OpenSourceSDRLab/USRP-B210-Artix-7-AD9361/hardware/USRP-B210-Artix-7-AD9361_Schematic.pdf

## © 2026 OpenSourceSDRLab. All rights reserved. · www.opensourcesdrlab.com

# OPENSOURCESDRLAB DOCUMENTATION

# USRP-B210-Artix-7-AD9361 Schematic

Product | USRP-B210-Artix-7-AD9361
Document | OSSDRLAB-USRP-B210-Artix-7-AD9361-SCH
Version | 1.0
Date | 2026-11-12

Circuit schematic of the OpenSourceSDRLab USRP B210 (Artix-7), a USRP B210-compatible SDR with an Analog Devices AD9361 and a Xilinx Artix-7 XC7A75T or XC7A200T FPGA. Exported from Altium Designer (A4); sheet 13 is blank. The short Chinese notes on sheets 6 and 7 mark pins that may be swapped within an FPGA bank; the note on sheet 12 says that there is no onboard GPSDO (external reference inputs only).

Sheet | Content
1–2 | USB 3.0: CYUSB3014 (FX3) controller, GPIF II bus, Type-C connector and FX3 supply
3 | Power: MP2145 step-down converters, TPS7A9101 low-noise LDOs
4–5 | FPGA configuration, power pins and decoupling
6–7 | FPGA I/O banks: AD9361 interface, FX3 GPIF II, PLL control, GPIO
8 | AD9361 RF transceiver
9–10 | RF front ends, channel 1 (TRX1, RX1) and channel 2 (TRX2, RX2)
11 | Status LEDs, MX1.25 GPIO connector, FPGA and FX3 JTAG
12 | Clocking: ADF4001 PLL, external 10 MHz and PPS inputs (no onboard GPSDO)

Product page: https://opensourcesdrlab.com/products/opensourcesdrlab-usrp-b210-ad9361-and-xilinx-xc7a75t-or-xc7a200t (https://opensourcesdrlab.com/products/opensourcesdrlab-usrp-b210-ad9361-and-xilinx-xc7a75t-or-xc7a200t)

# Questions about the hardware: support@opensourcesdrlab.com

] F7 | GPIO[5] F8 | GPIO[1] F9 | GPIO[0] F10 | GPIO[42]/A

C110

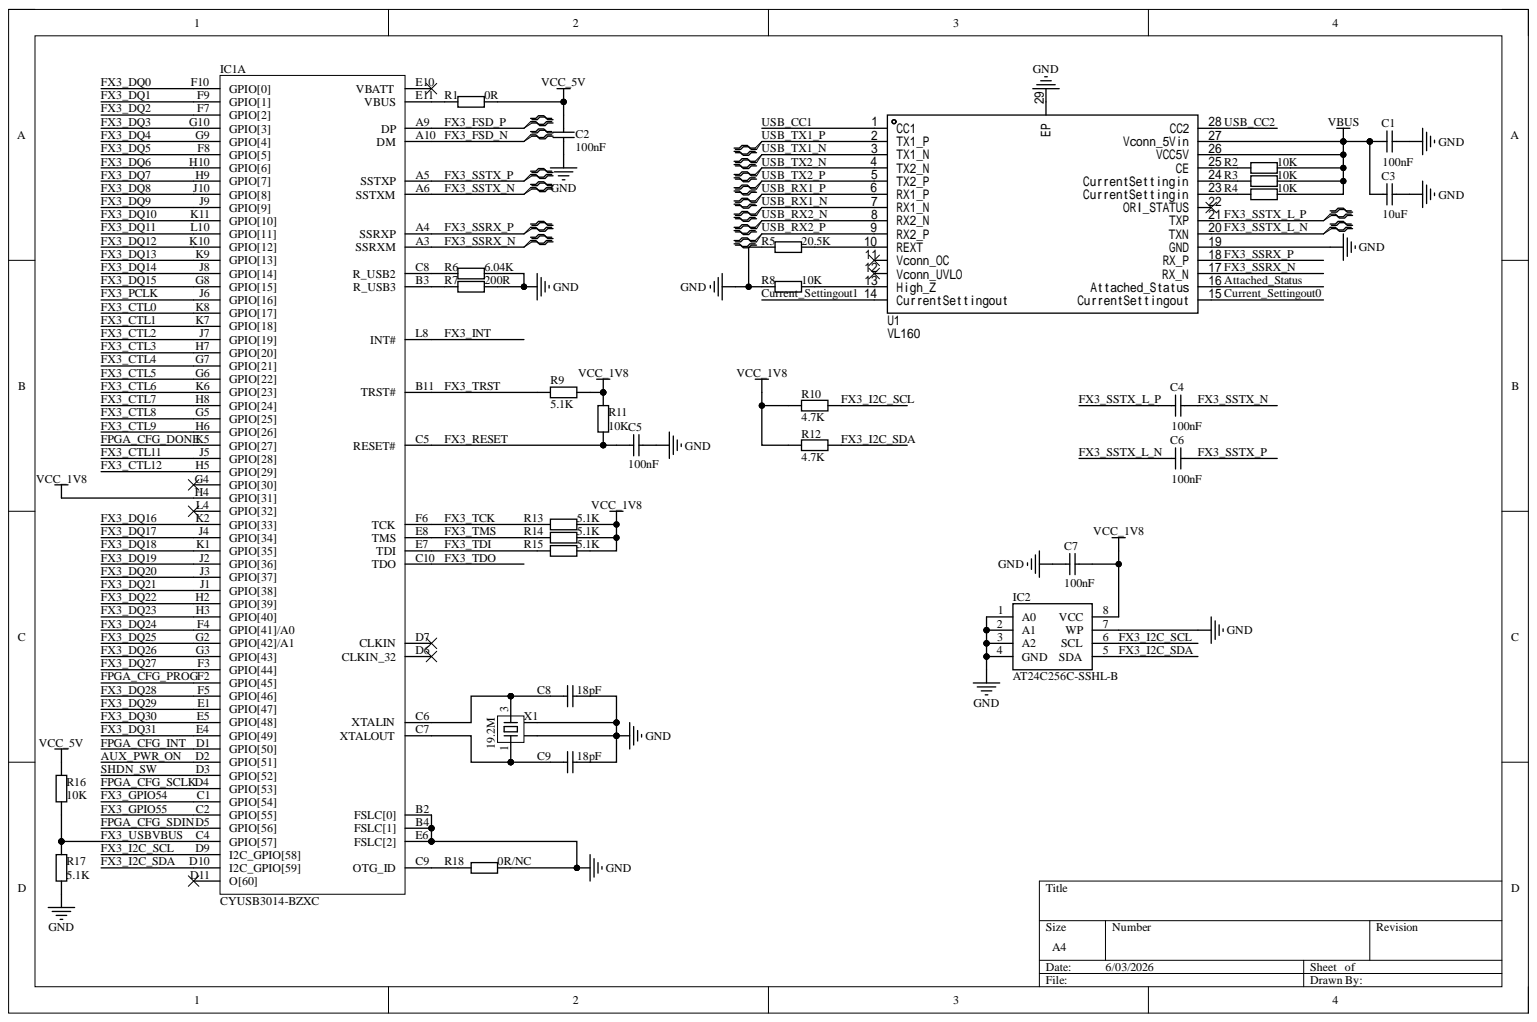
[picture p7: page 2]

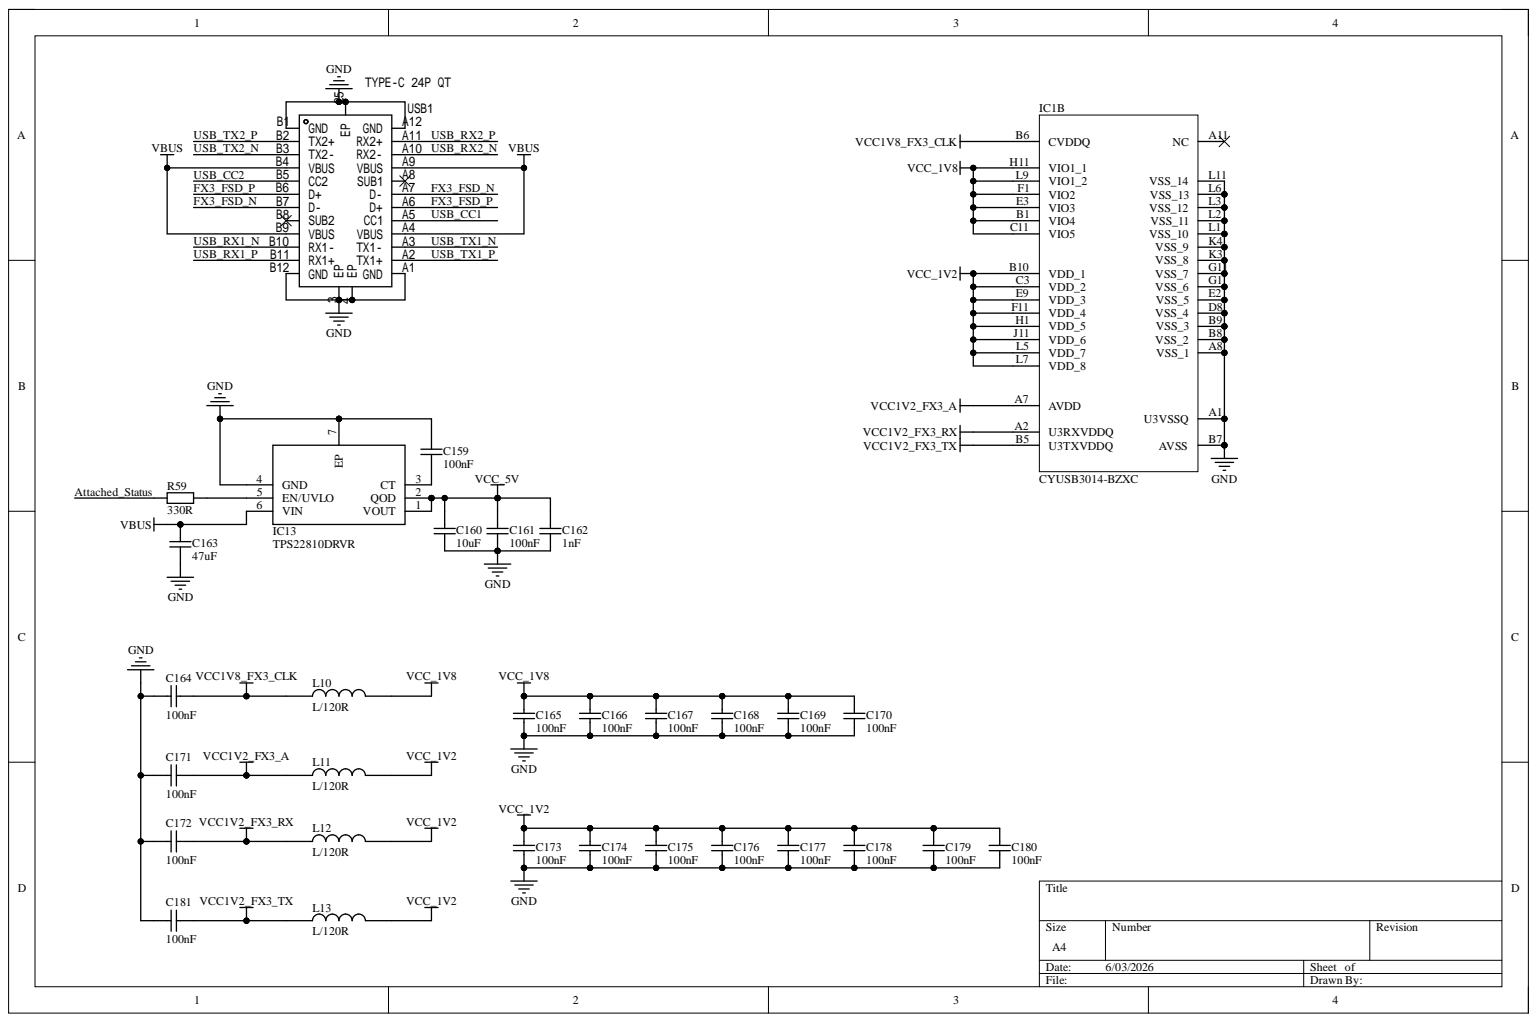
[picture p8: page 3]

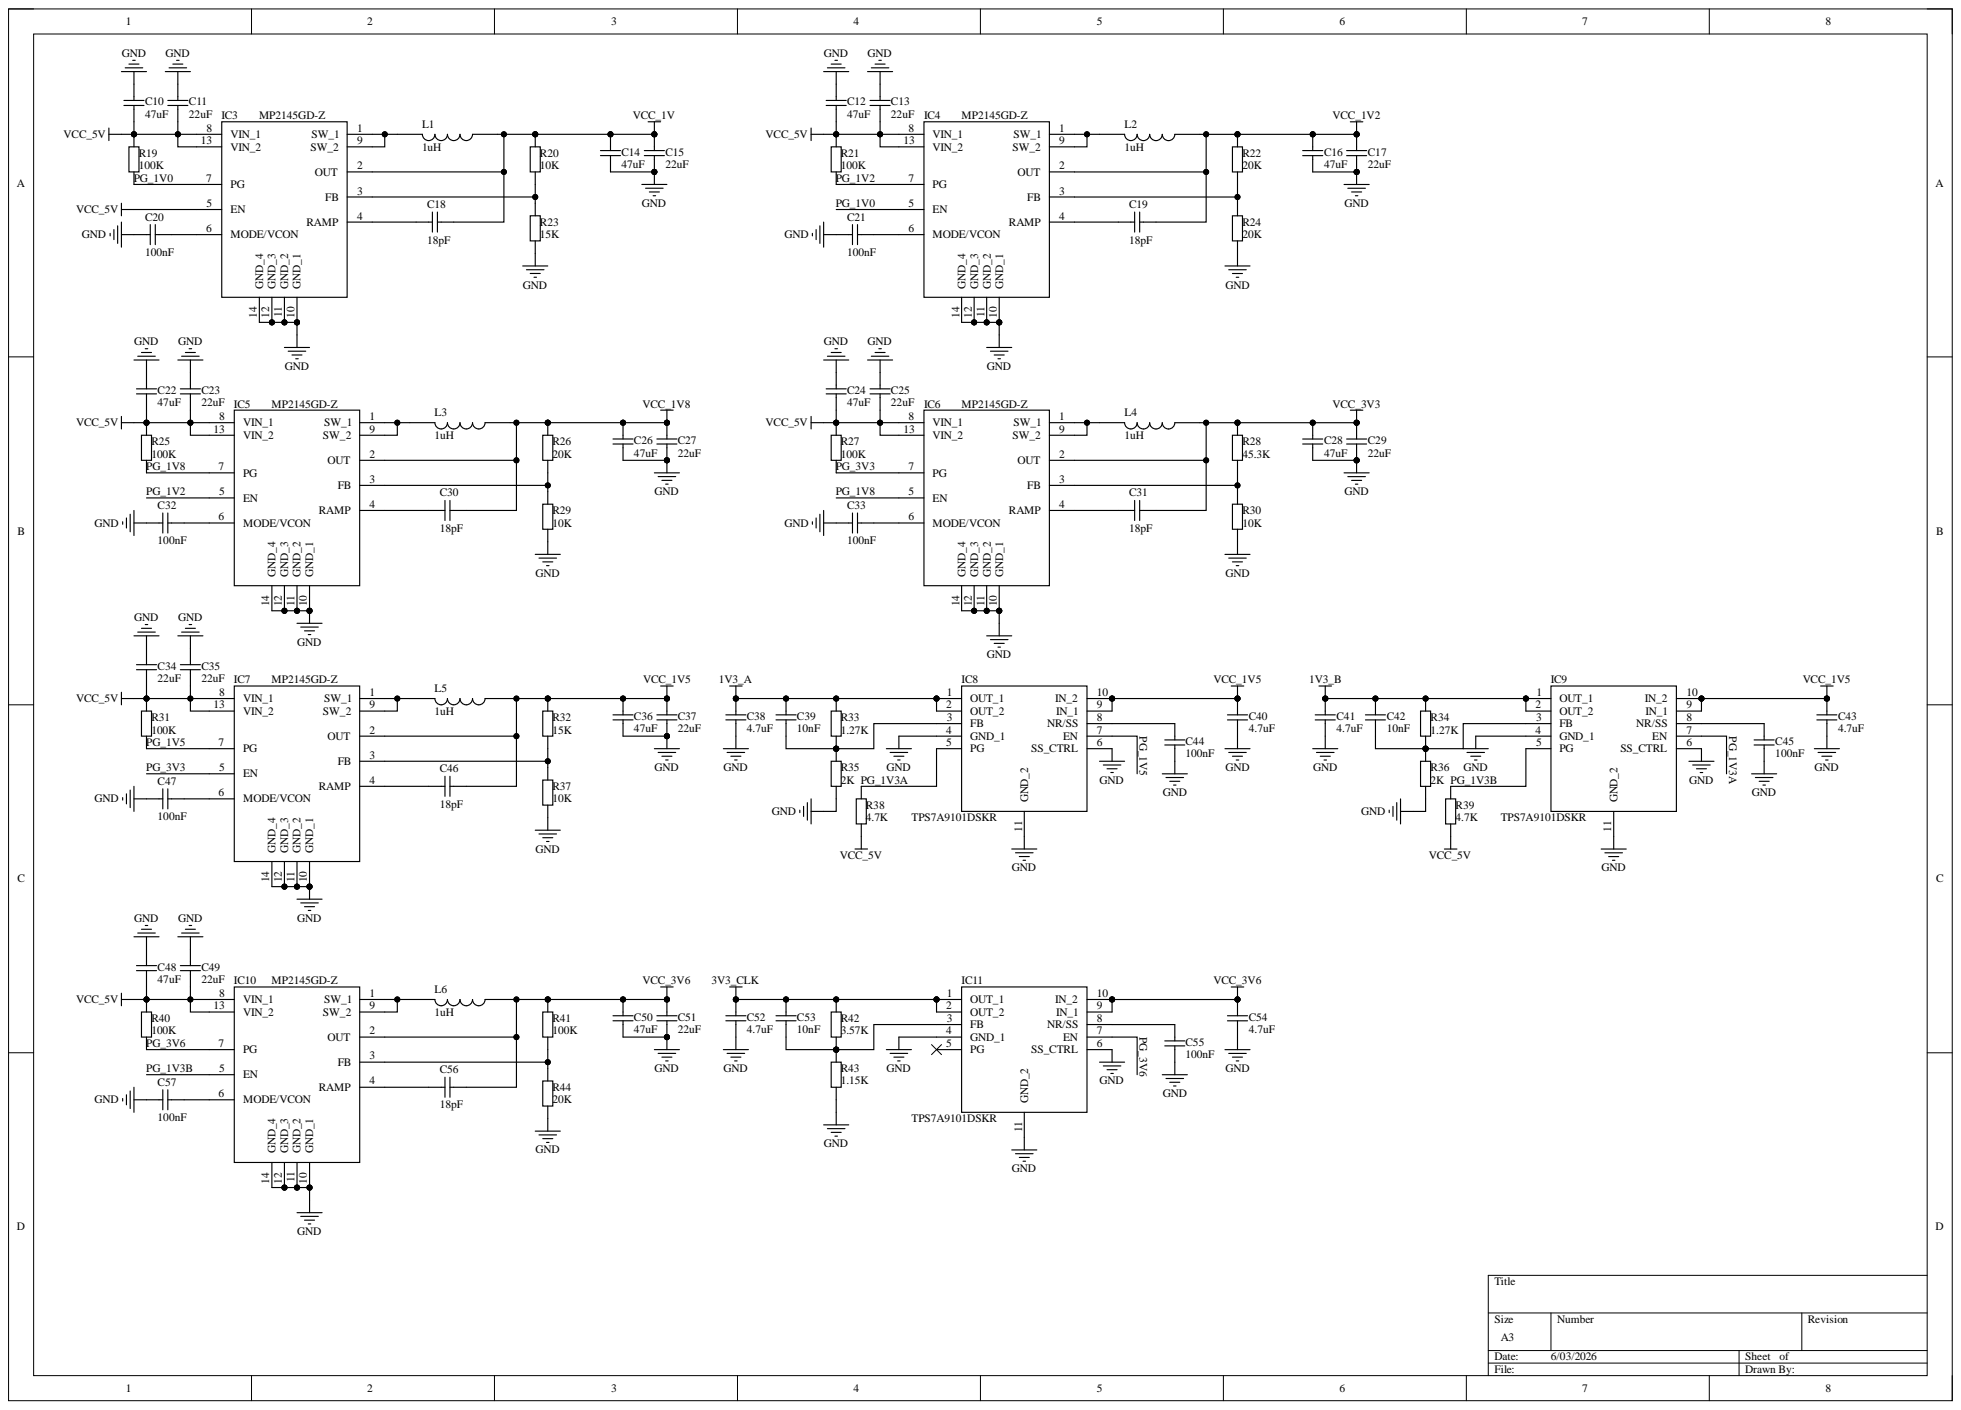
[picture p9: page 4]

0 M10 | VN_0 M9 | TCK_0 V12 | DONE_0 G11 U2G XC7A75T-1FG

### COU2G

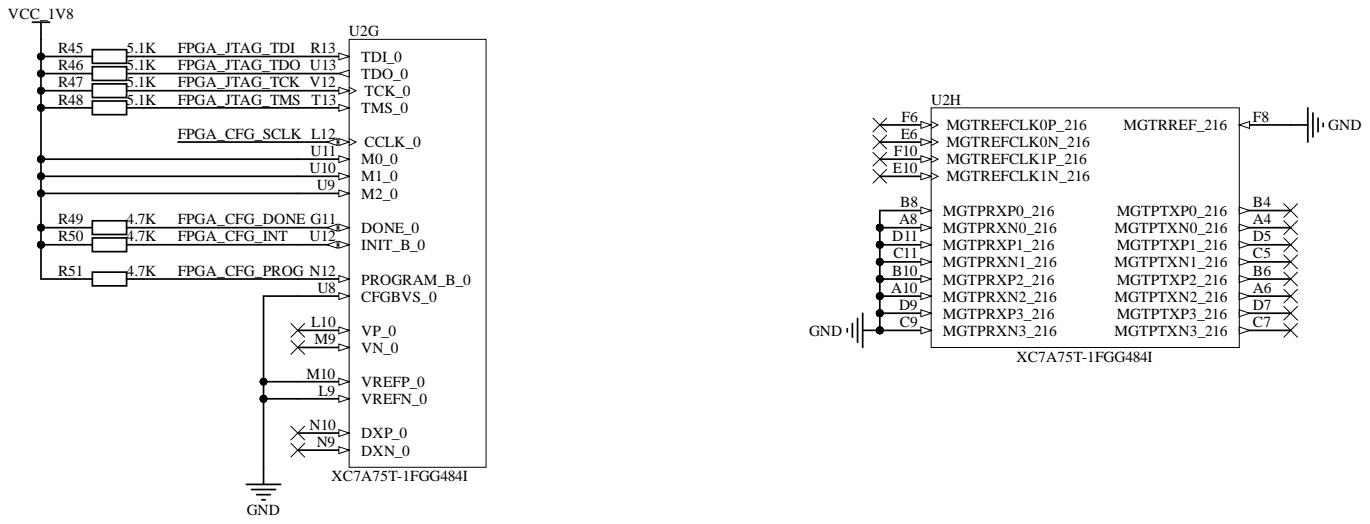
[picture p10: page 5]

GND | Y15 GND | Y5 GND | W18 GND | W8 GND | V21 GND | V11 GND | V1 GND | U14 GND | U4 GND | T17 GND | T11 GND | T9 GND | T7 GND | R20 GND | R12 GND | R10 GND | R8 GND | P13 GND | P11 GND | P9 GND | P7 GND | P3 GND | N16 GND | N8 GND | N6 GND | M19 GND | M11 GND | M7 GND | L22 GND | L8 GND | L2 GND | K15 GND | K11 GND | K7 GND | K5 GND | J18 GND | J12 GND | J10
GND J8 | GND H21 | GND H11 | GND H9 | GND H7 | GND H1 | GND G14 | GND G12 | GND G10 | GND G9 | GND G8 | GND G7 | GND G6 | GND G5 | GND F17 | GND F11 | GND F5 | GND E20 | GND E11 | GND E9 | GND E7 | GND E5 | GND E4 | GND D13 | GND D12

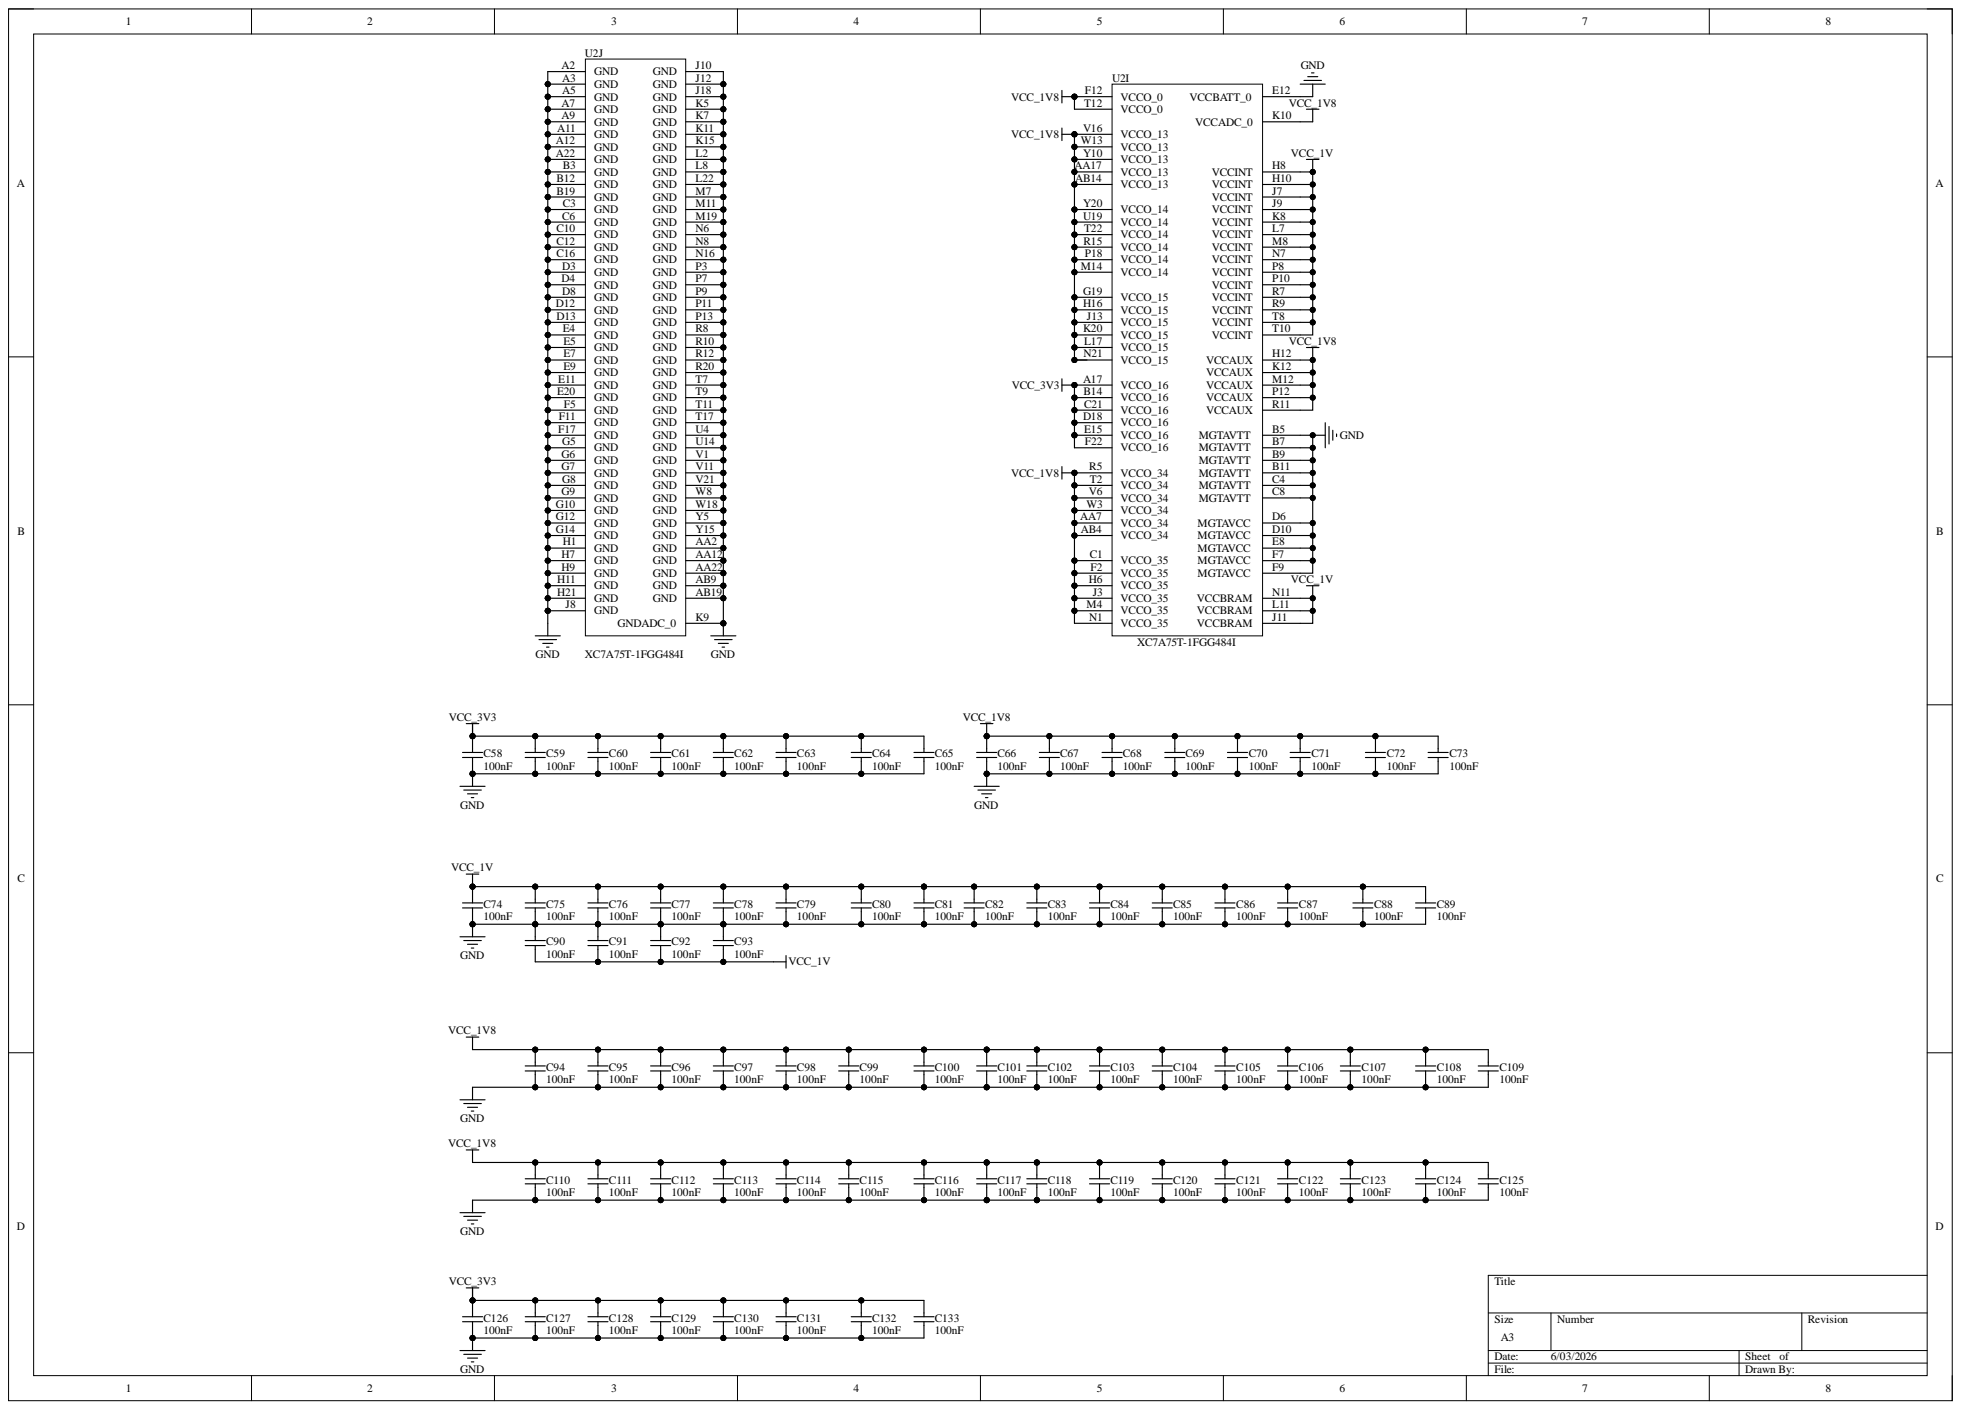
[picture p11: page 6]

8 IO_L17P_T2_A14_D30_14 | AA18 IO_L16N_T2_A15_D31_14 | W17 IO_L16P_T2_CSI_B_14 | V17 IO_L15N_T2_DQS_DOUT_CSO_B_14 | AB20 IO_L15P_T2_DQS_RDWR_B_14 | AA19 IO_L14N_T2_SRCC_14 | V19 IO_L14P_T2_SRCC_14 | V18 IO_L13N_T2_MRCC_14 | Y19 IO_L13P_T2_MRCC_14 | Y18 IO_L12N_T1_MRCC_14 | W20 IO_L12P_T1_MRCC_14 | W19 IO_L11N_T1_SRCC_14 | V20 IO_L11P_T1_SRCC_14 | U20 IO_L10N_T1_D15_14 | AB22 IO_L10P_T1_D14_14 | AB21 IO_L9N_T1_DQS_D13_14 | Y22 IO_L9P_T1_DQS_14 | Y21 IO_L8N_T1_D12_14 | AA21 IO_L8P_T1_D11_14 | AA20 IO_L7N_T1_D10_14 | W22 IO_L7P_T1_D09_14 | W21 IO_L6N_T0_D08_VREF_14 | T20 IO_L6P_T0_FCS_B_14 | T19 IO_L5N_T0_D07_14 | R19 IO_L5P_T0_D06_14 | P19 IO_L4N_T0_D05_14 | U21 IO_L4P_T0_D04_14 | T21 IO_L3N_T0_DQS_EMCCLK_14 | V22 IO_L3P_T0_DQS_PUDC_B_14 | U22 IO_L2N_T0_D03_14 | R21 IO_L2P_T0_D02_14 | P21 IO_L1N_T0_D01_DIN_14 | R22 IO_L1P_T0_D00_MOSI_14 | P22 IO_0_14 | P20 BANK ¹⁴ U2B XC7A75T-1FGG484I
7 IO_L24N_T3_RS0_15 | M16 IO_L24P_T3_RS1_15 | M15 IO_L23N_T3_FWE_B_15 | K16 IO_L23P_T3_FOE_B_15 | L16 IO_L22N_T3_A16_15 | L15 IO_L22P_T3_A17_15 | L14 IO_L21N_T3_DQS_A18_15 | J17 IO_L21P_T3_DQS_15 | K17 IO_L20N_T3_A19_15 | L13 IO_L20P_T3_A20_15 | M13 IO_L19N_T3_A21_VREF_15 | K14 IO_L19P_T3_A22_15 | K13 IO_L18N_T2_A23_15 | M20 IO_L18P_T2_A24_15 | N20 IO_L17N_T2_A25_15 | N19 IO_L17P_T2_A26_15 | N18 IO_L16N_T2_A27_15 | L18 IO_L16P_T2_A28_15 | M18 IO_L15N_T2_DQS_ADV_B_15 | M22 IO_L15P_T2_DQS_15 | N22 IO_L14N_T2_SRCC_15 | L20 IO_L14P_T2_SRCC_15 | L19 IO_L13N_T2_MRCC_15 | K19 IO_L13P_T2_MRCC_15 | K18 IO_L12N_T1_MRCC_15 | H19 IO_L12P_T1_MRCC_15 | J19 IO_L11N_T1_SRCC_15 | J21 IO_L11P_T1_SRCC_15 | J20 IO_L10N_T1_AD11N_15 | L21 IO_L10P_T1_AD11P_15 | M21 IO_L9N_T1_DQS_AD3N_15 | K22 IO_L9P_T1_DQS_AD3P_15 | K21 IO_L8N_T1_AD10N_15 | G20 IO_L8P_T1_AD10P_15 | H20 IO_L7N_T1_AD2N_15 | H22 IO_L7P_T1_AD2P_15 | J22 IO_L6N_T0_VREF_15 | H18 IO_L6P_T0_15 | H17 IO_L5N_T0_AD9N_15 | H15 IO_L5P_T0_AD9P_15 | J15 IO_L4N_T0_15 | G18 IO_L4P_T0_15 | G17 IO_L3N_T0_DQS_AD1N_15 | H14 IO_L3P_T0_DQS_AD1P_15 | J14 IO_L2N_T0_AD8N_15 | G16 IO_L2P_T0_AD8P_15 | G15 IO_L1N_T0_AD0N_15 | G13 IO_L1P_T0_AD0P_15 | H13 IO_0_15 | J16

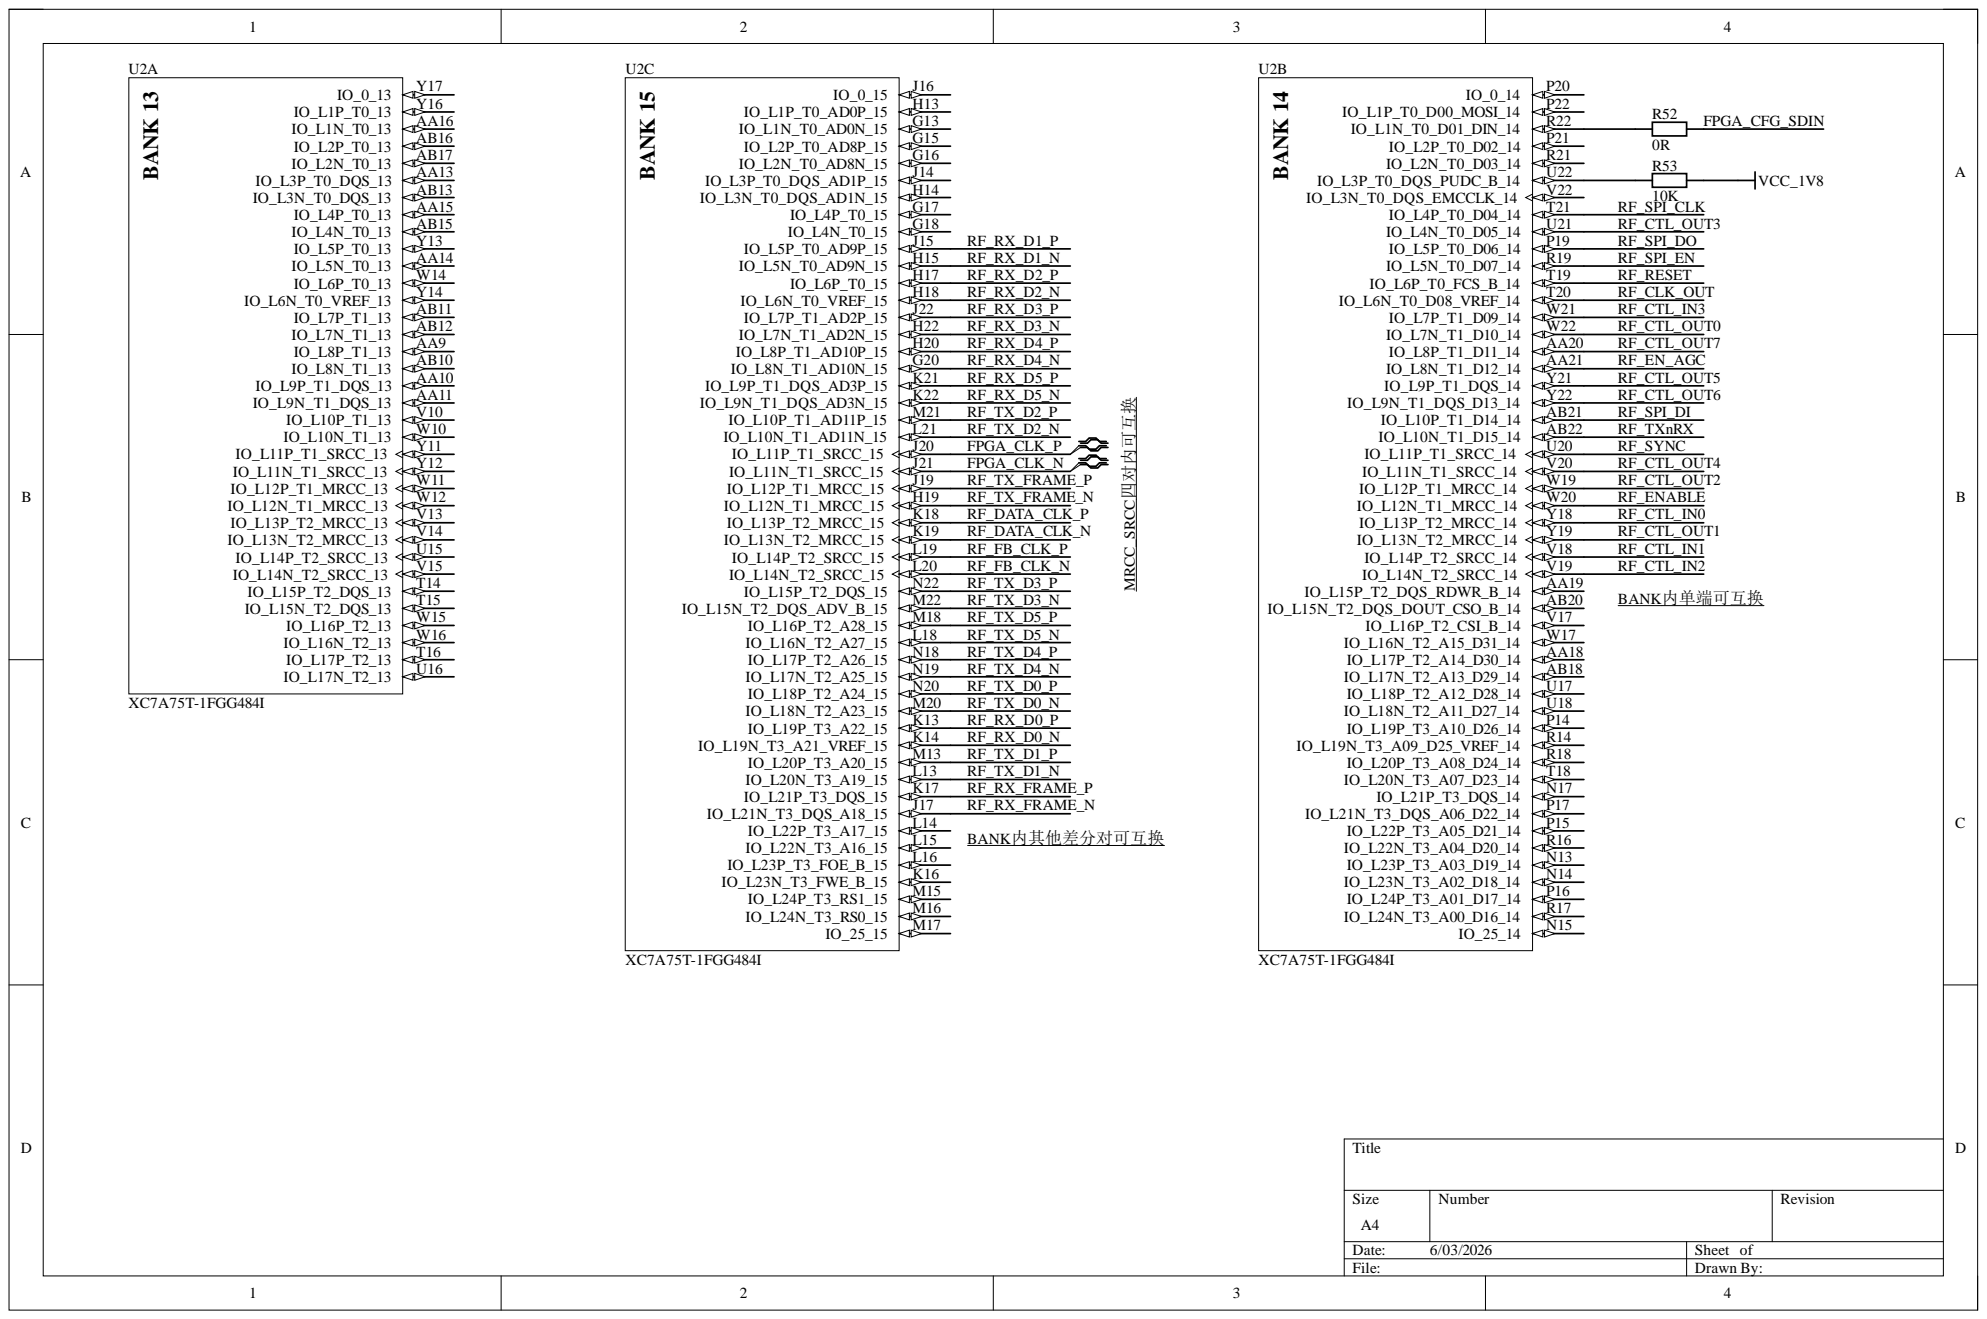
[picture p12: page 7]

1 IO_L24N_T3_16 | G22 IO_L24P_T3_16 | G21 IO_L23N_T3_16 | D21 IO_L23P_T3_16 | E21 IO_L22N_T3_16 | D22 IO_L22P_T3_16 | E22 IO_L21N_T3_DQS_16 | A21 IO_L21P_T3_DQS_16 | B21 IO_L20N_T3_16 | B22 IO_L20P_T3_16 | C22 IO_L19N_T3_VREF_16 | C20 IO_L19P_T3_16 | D20 IO_L18N_T2_16 | F20 IO_L18P_T2_16 | F19 IO_L17N_T2_16 | A19 IO_L17P_T2_16 | A18 IO_L16N_T2_16 | A20 IO_L16P_T2_16 | B20 IO_L15N_T2_DQS_16 | E18 IO_L15P_T2_DQS_16 | F18 IO_L14N_T2_SRCC_16 | D19 IO_L14P_T2_SRCC_16 | E19 IO_L13N_T2_MRCC_16 | C19 IO_L13P_T2_MRCC_16 | C18 IO_L12N_T1_MRCC_16 | C17 IO_L12P_T1_MRCC_16 | D17 IO_L11N_T1_SRCC_16 | B18 IO_L11P_T1_SRCC_16 | B17 IO_L10N_T1_16 | A14 IO_L10P_T1_16 | A13 IO_L9N_T1_DQS_16 | A16 IO_L9P_T1_DQS_16 | A15 IO_L8N_T1_16 | B13 IO_L8P_T1_16 | C13 IO_L7N_T1_16 | B16 IO_L7P_T1_16 | B15 IO_L6N_T0_VREF_16 | D15 IO_L6P_T0_16 | D14 IO_L5N_T0_16 | D16 IO_L5P_T0_16 | E16 IO_L4N_T0_16 | E14 IO_L4P_T0_16 | E13 IO_L3N_T0_DQS_16 | C15 IO_L3P_T0_DQS_16 | C14 IO_L2N_T0_16 | E17 IO_L2P_T0_16 | F16 IO_L1N_T0_16 | F14 IO_L1P_T0_16 | F13 IO_0_16 | F15
8 IO_L22P_T3_34 | AA8 IO_L21N_T3_DQS_34 | V8 IO_L21P_T3_DQS_34 | V9 IO_L20N_T3_34 | AB6 IO_L20P_T3_34 | AB7 IO_L19N_T3_VREF_34 | W7 IO_L19P_T3_34 | V7 IO_L18N_T2_34 | AA6 IO_L18P_T2_34 | Y6 IO_L17N_T2_34 | T6 IO_L17P_T2_34 | R6 IO_L16N_T2_34 | V5 IO_L16P_T2_34 | U6 IO_L15N_T2_DQS_34 | W5 IO_L15P_T2_DQS_34 | W6 IO_L14N_T2_SRCC_34 | U5 IO_L14P_T2_SRCC_34 | T5 IO_L13N_T2_MRCC_34 | T4 IO_L13P_T2_MRCC_34 | R4 IO_L12N_T1_MRCC_34 | W4 IO_L12P_T1_MRCC_34 | V4 IO_L11N_T1_SRCC_34 | AA4 IO_L11P_T1_SRCC_34 | Y4 IO_L10N_T1_34 | AB5 IO_L10P_T1_34 | AA5 IO_L9N_T1_DQS_34 | AA3 IO_L9P_T1_DQS_34 | Y3 IO_L8N_T1_34 | AB2 IO_L8P_T1_34 | AB3 IO_L7N_T1_34 | AB1 IO_L7P_T1_34 | AA1 IO_L6N_T0_VREF_34 | V3 IO_L6P_T0_34 | U3 IO_L5N_T0_34 | Y1 IO_L5P_T0_34 | W1 IO_L4N_T0_34 | Y2 IO_L4P_T0_34 | W2 IO_L3N_T0_DQS_34 | R2 IO_L3P_T0_DQS_34 | R3 IO_L2N_T0_34 | V2 IO_L2P_T0_34 | U2 IO_L1N_T0_34 | U1 IO_L1P_T0_34 | T1 IO_0_34 | T3

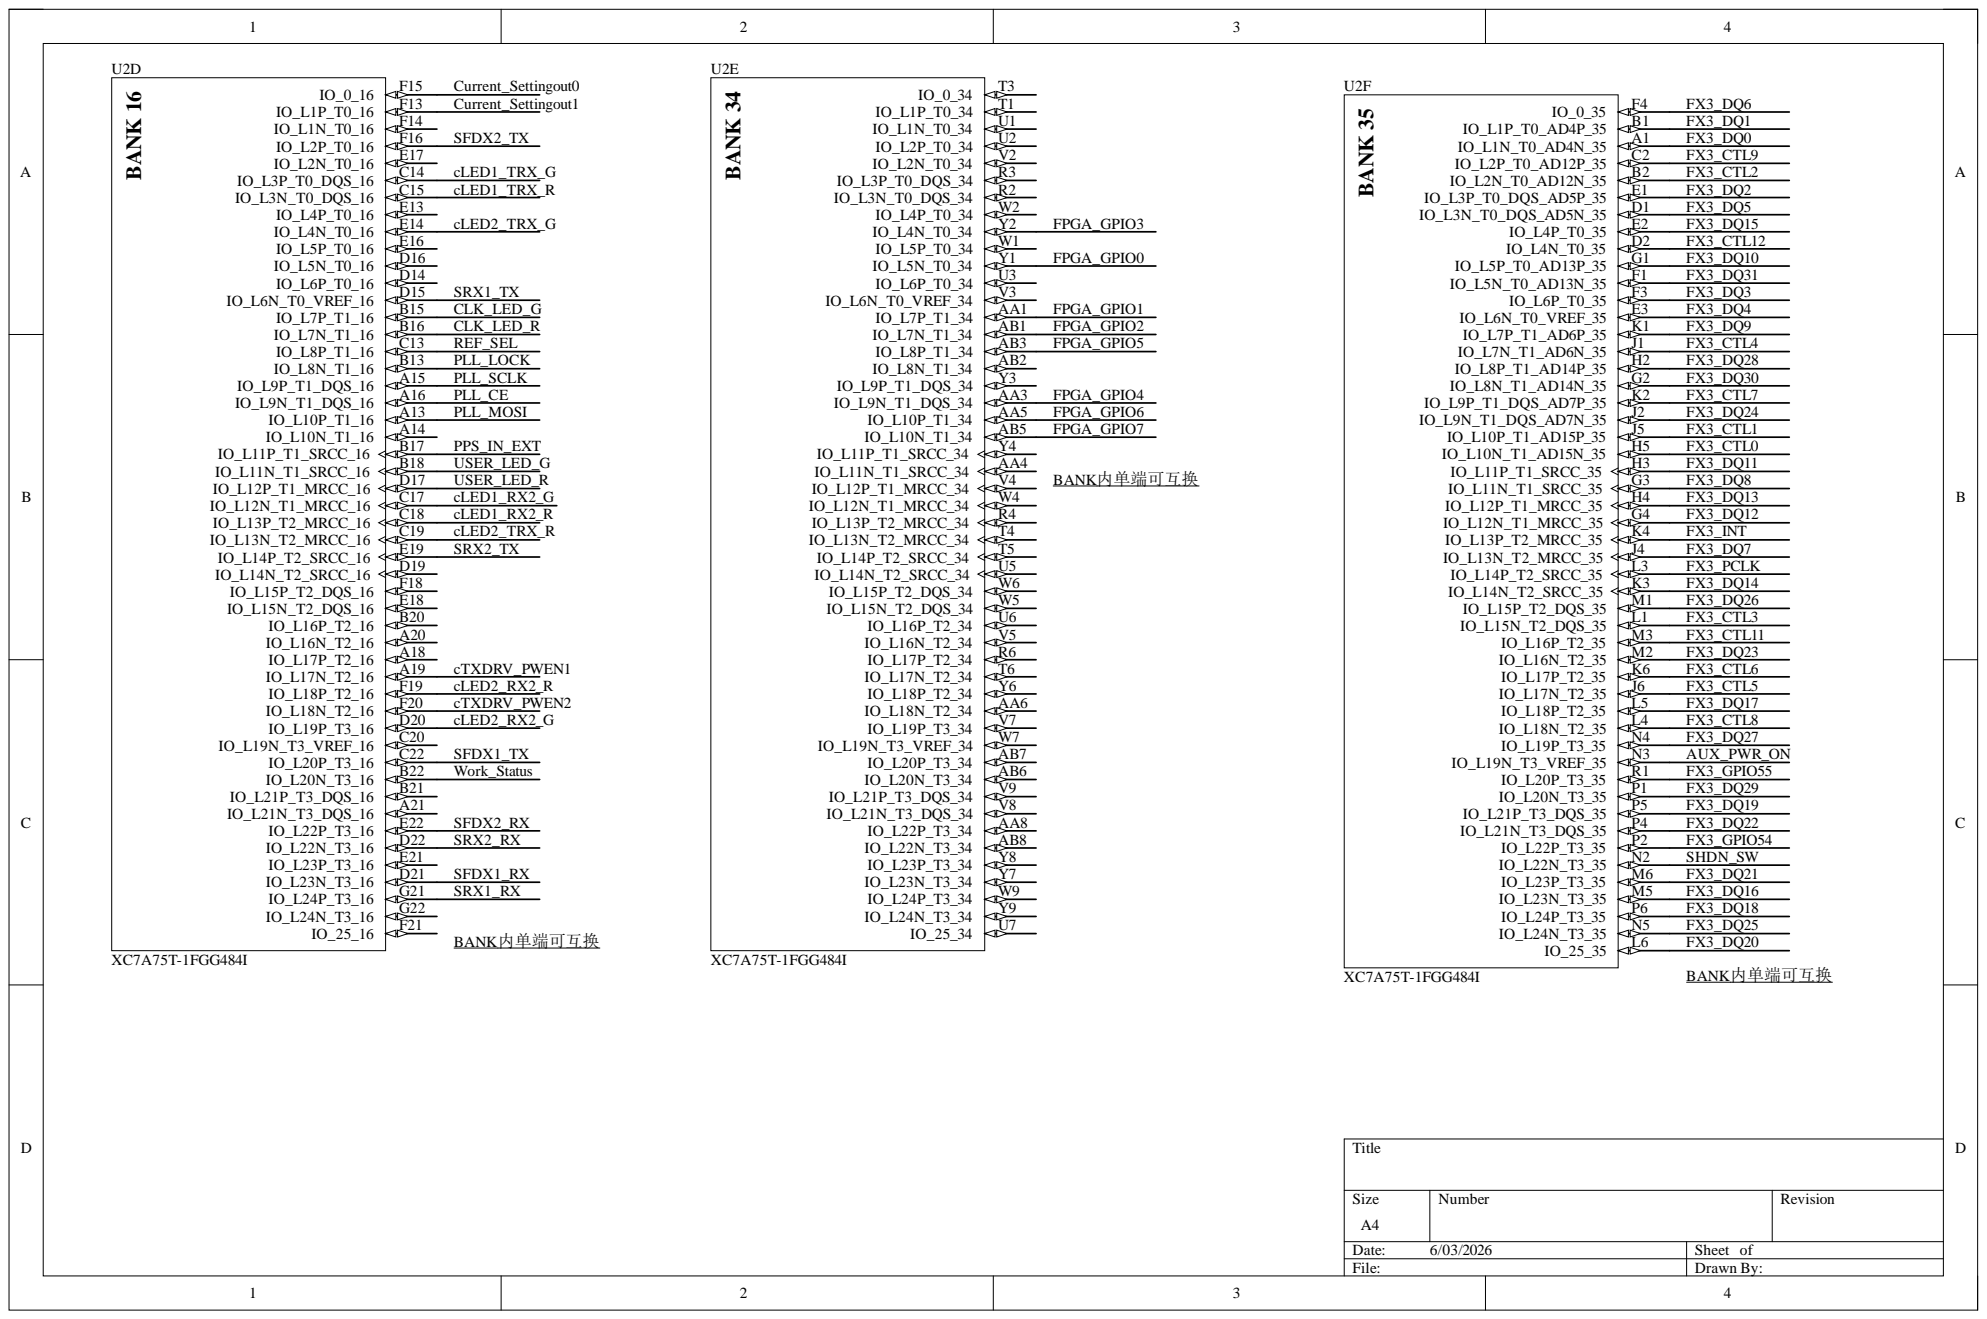
[picture p13: page 8]

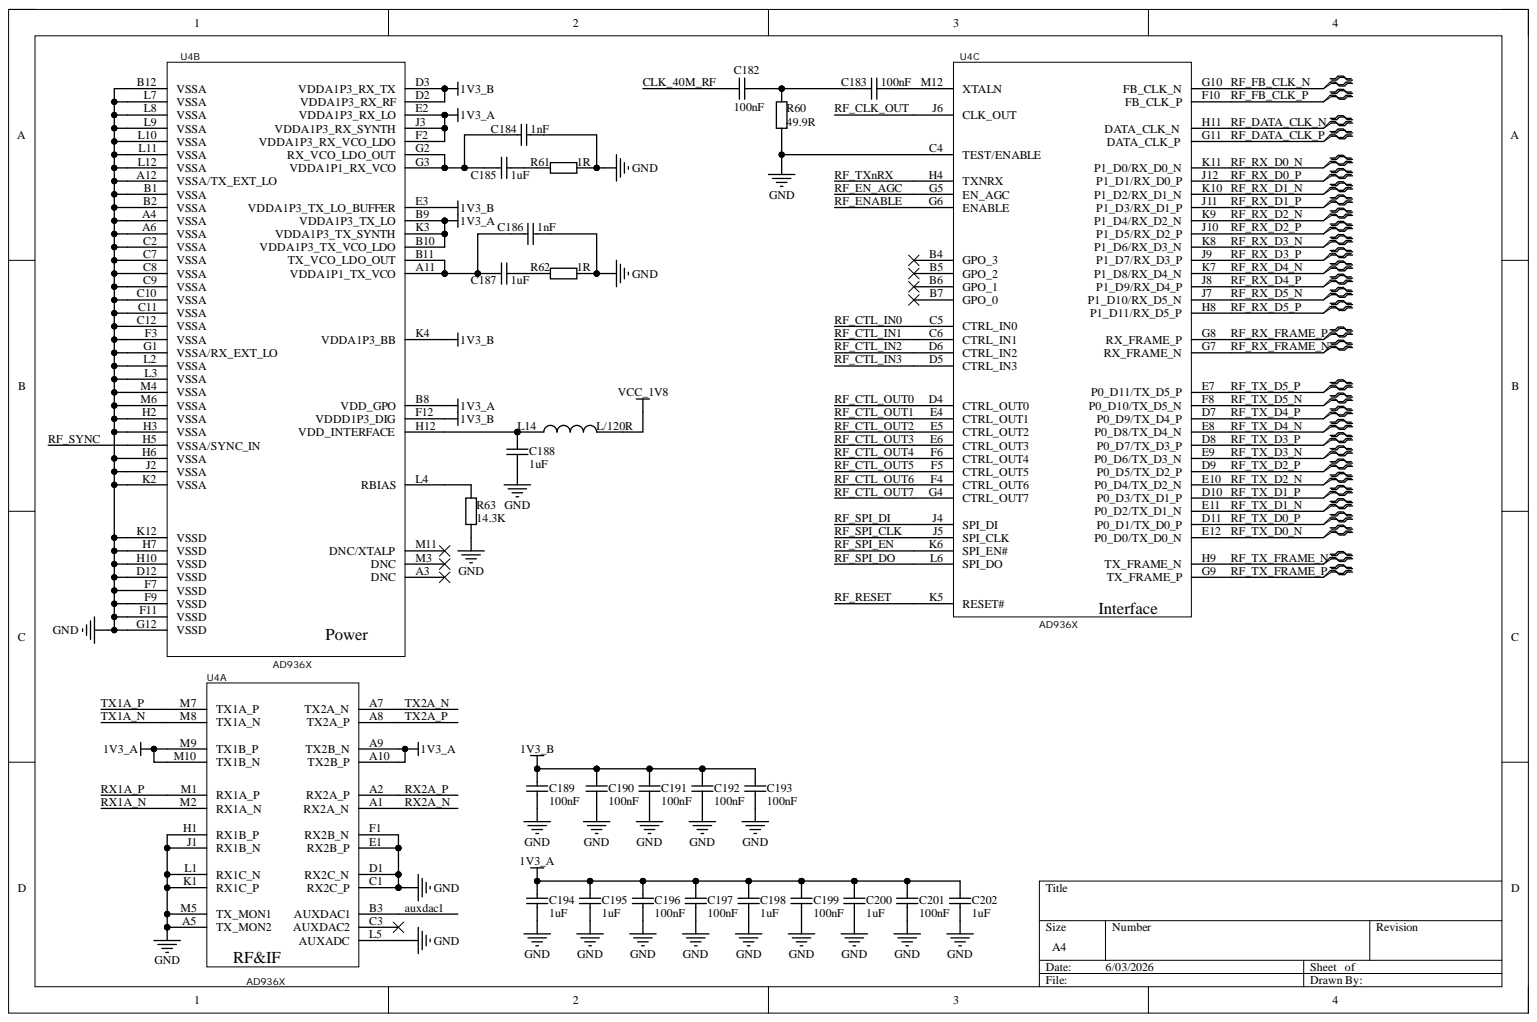
[picture p14: page 9]

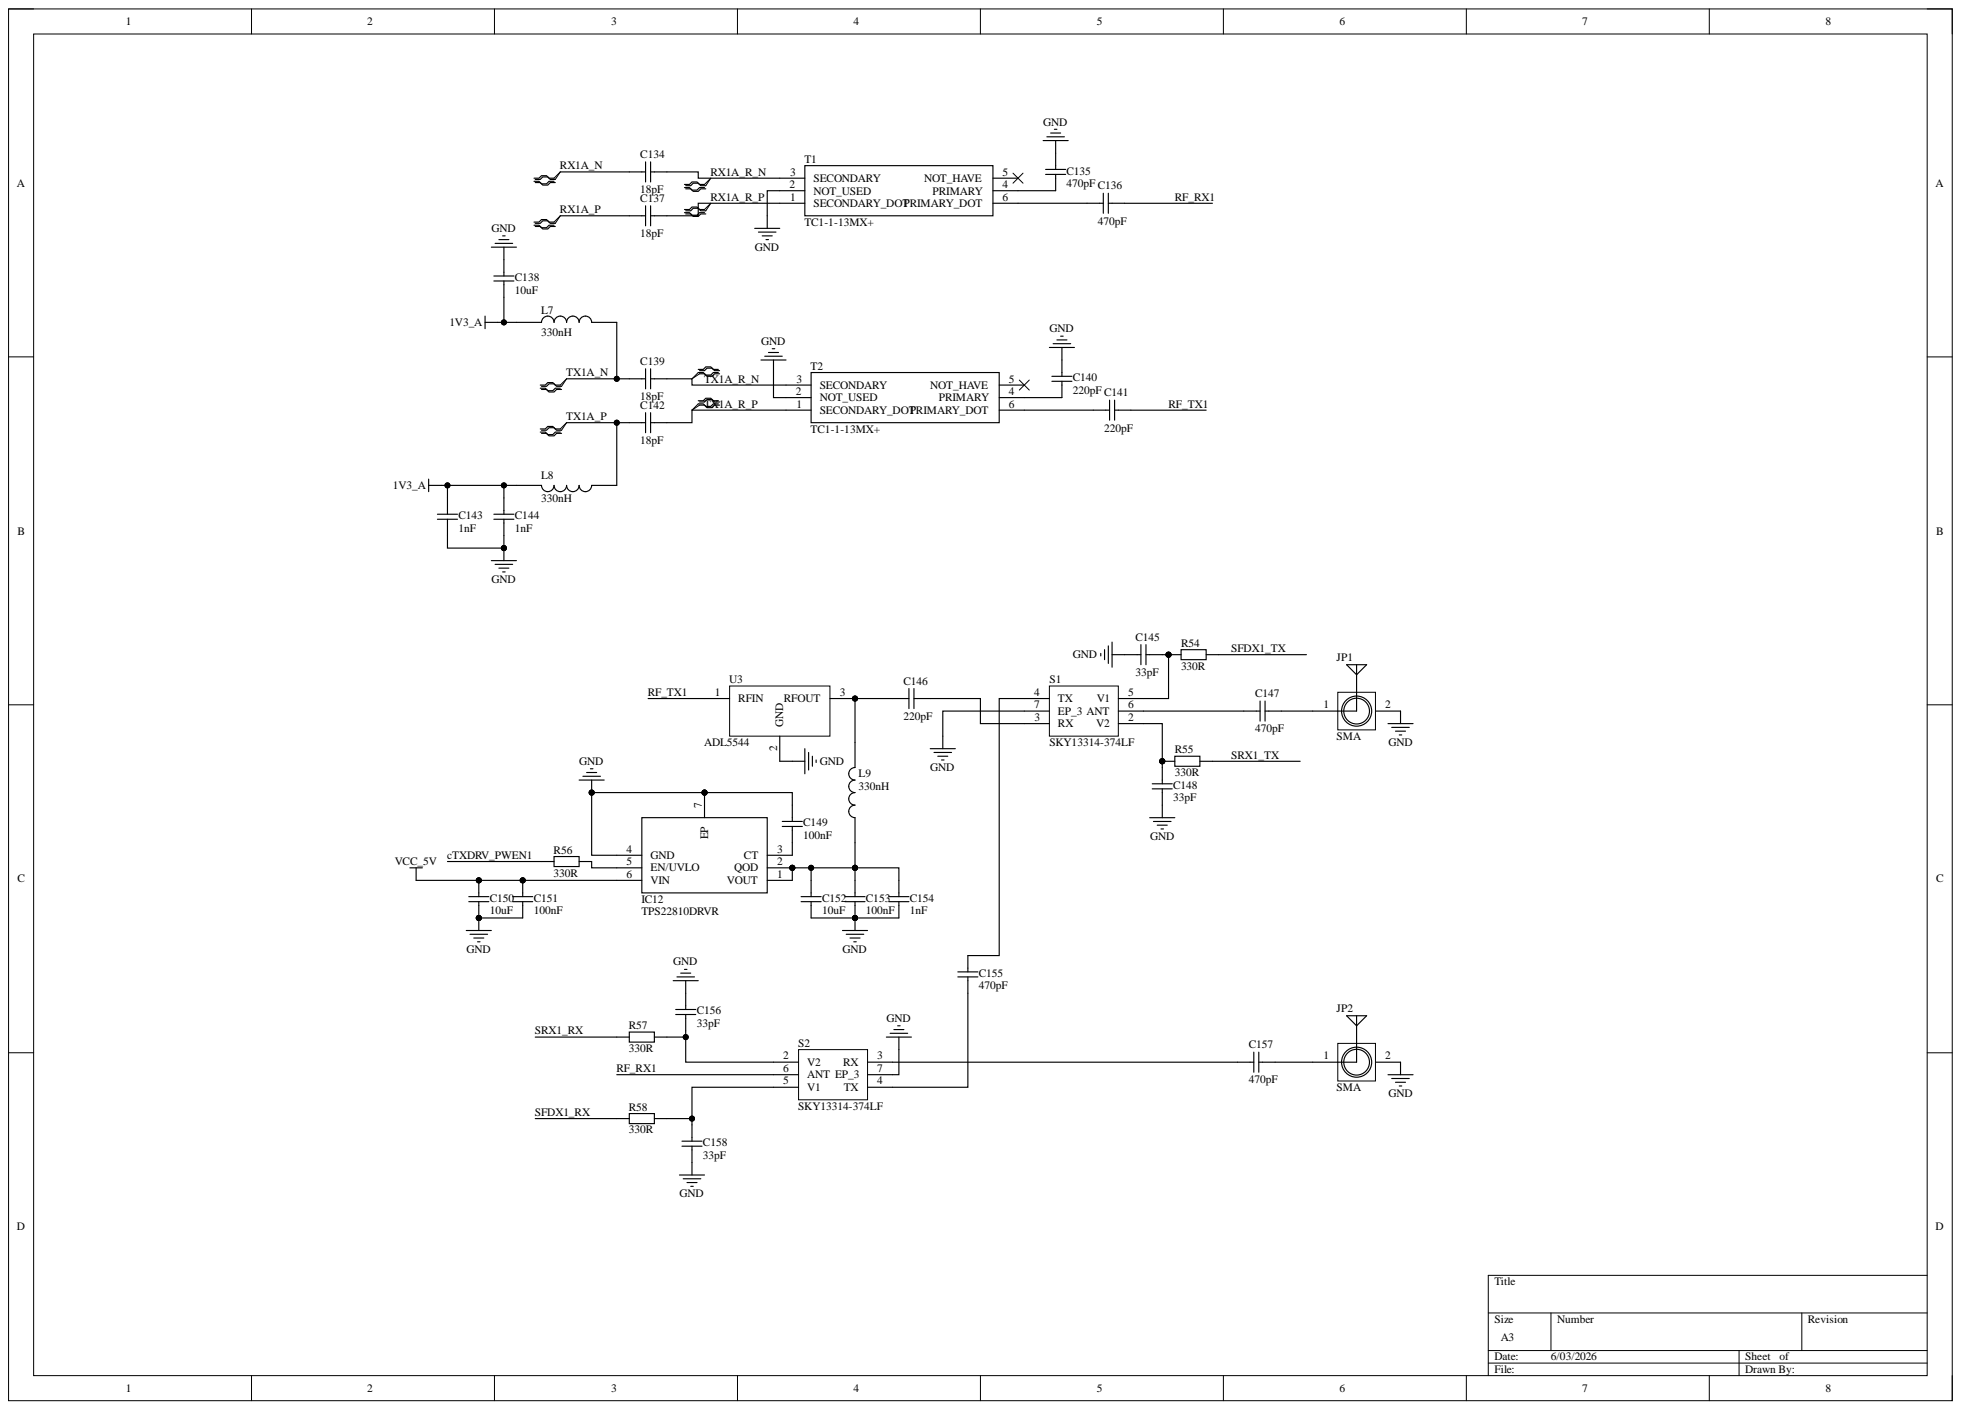
[picture p15: page 10]

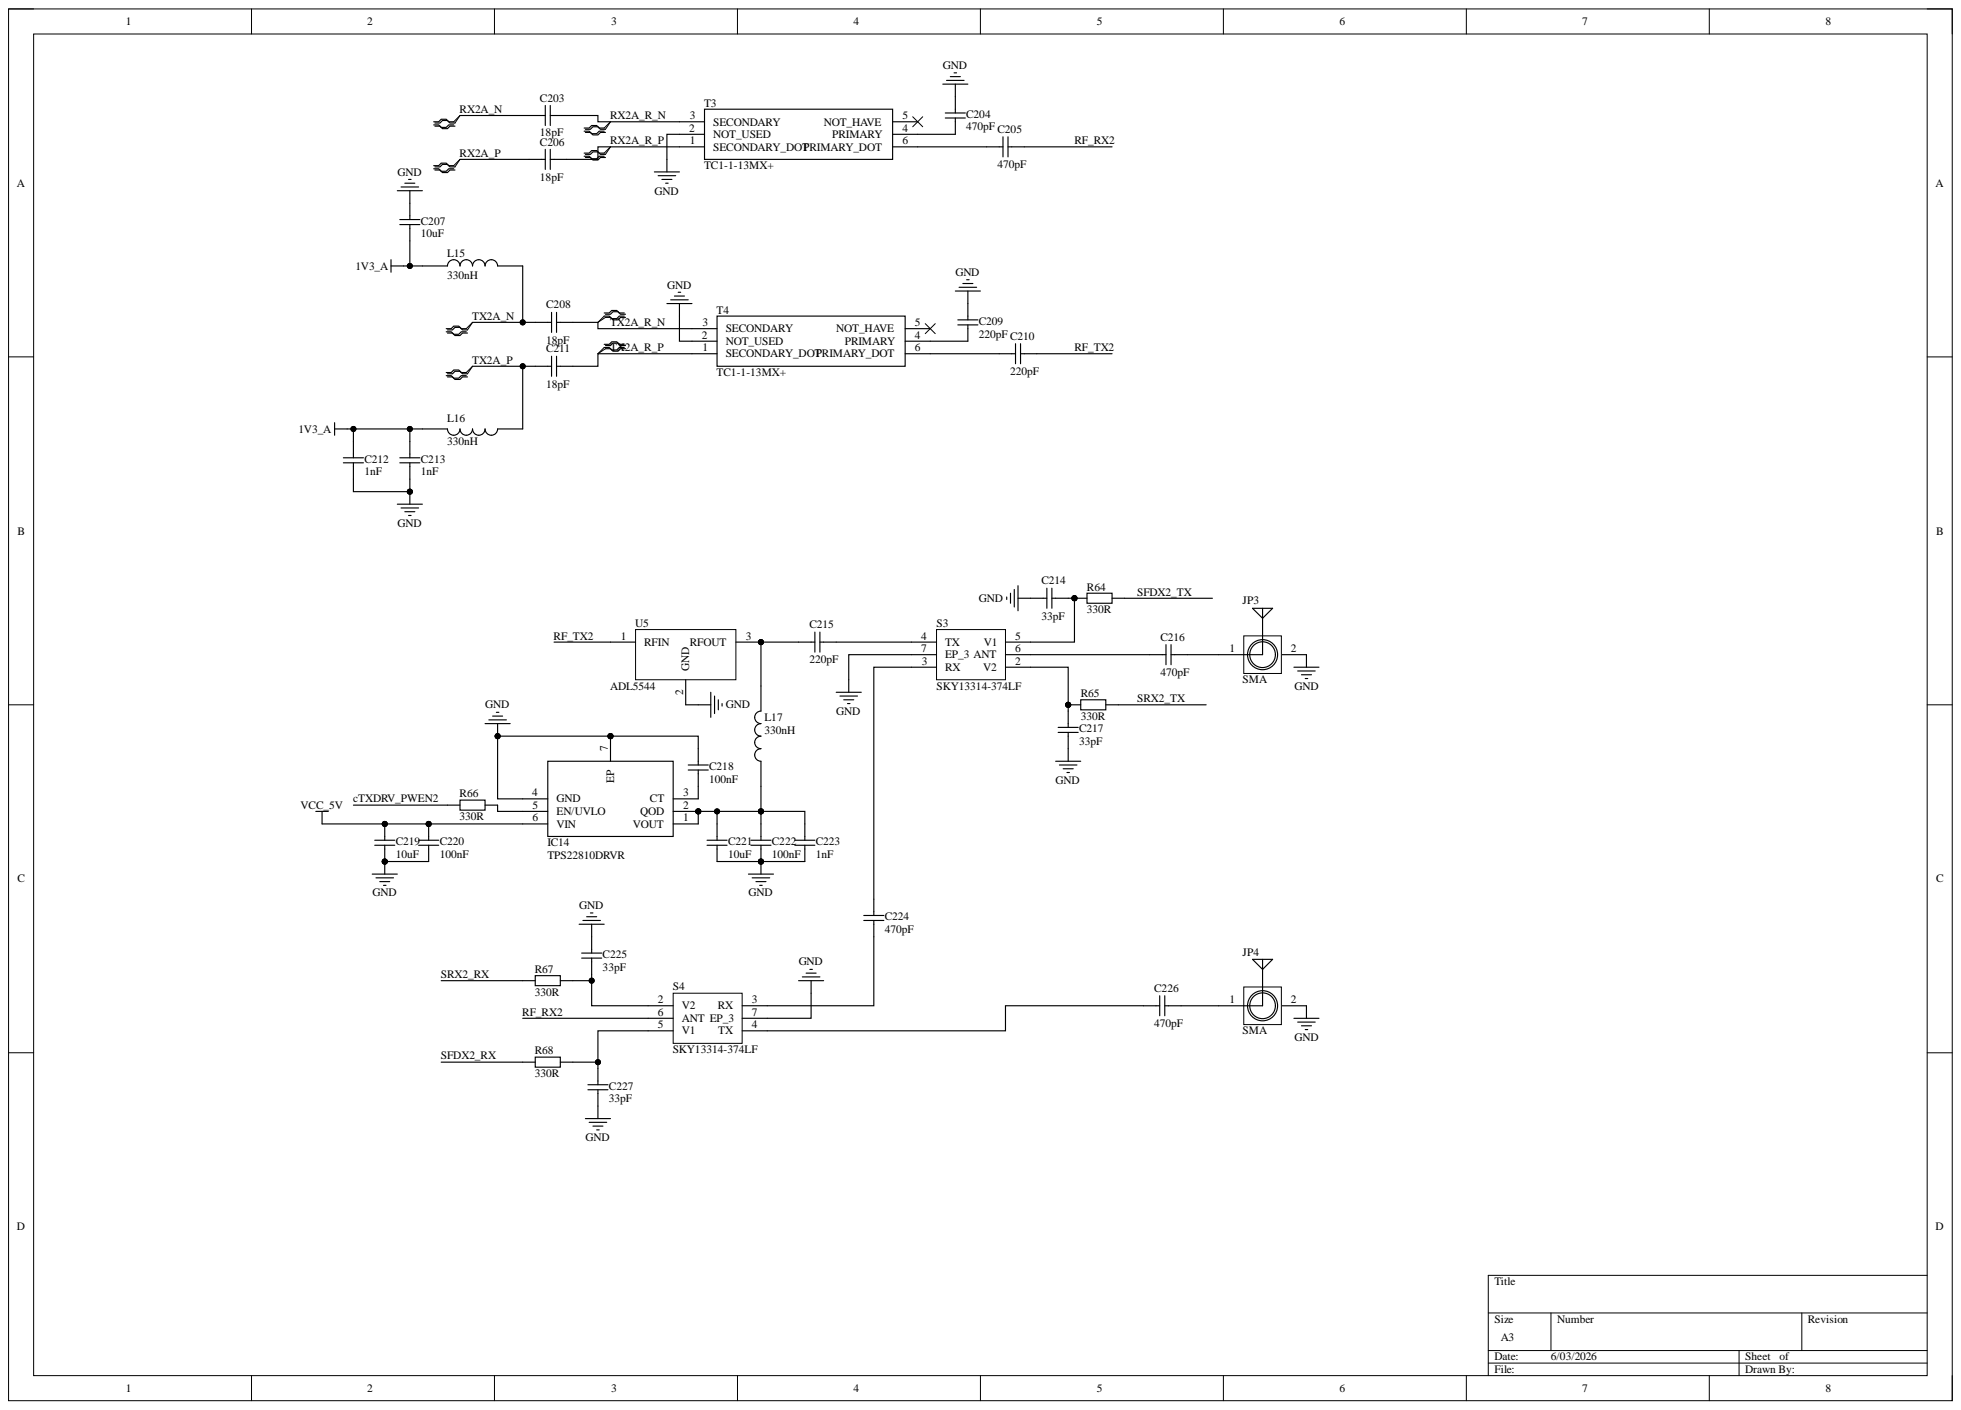
[picture p16: page 11]

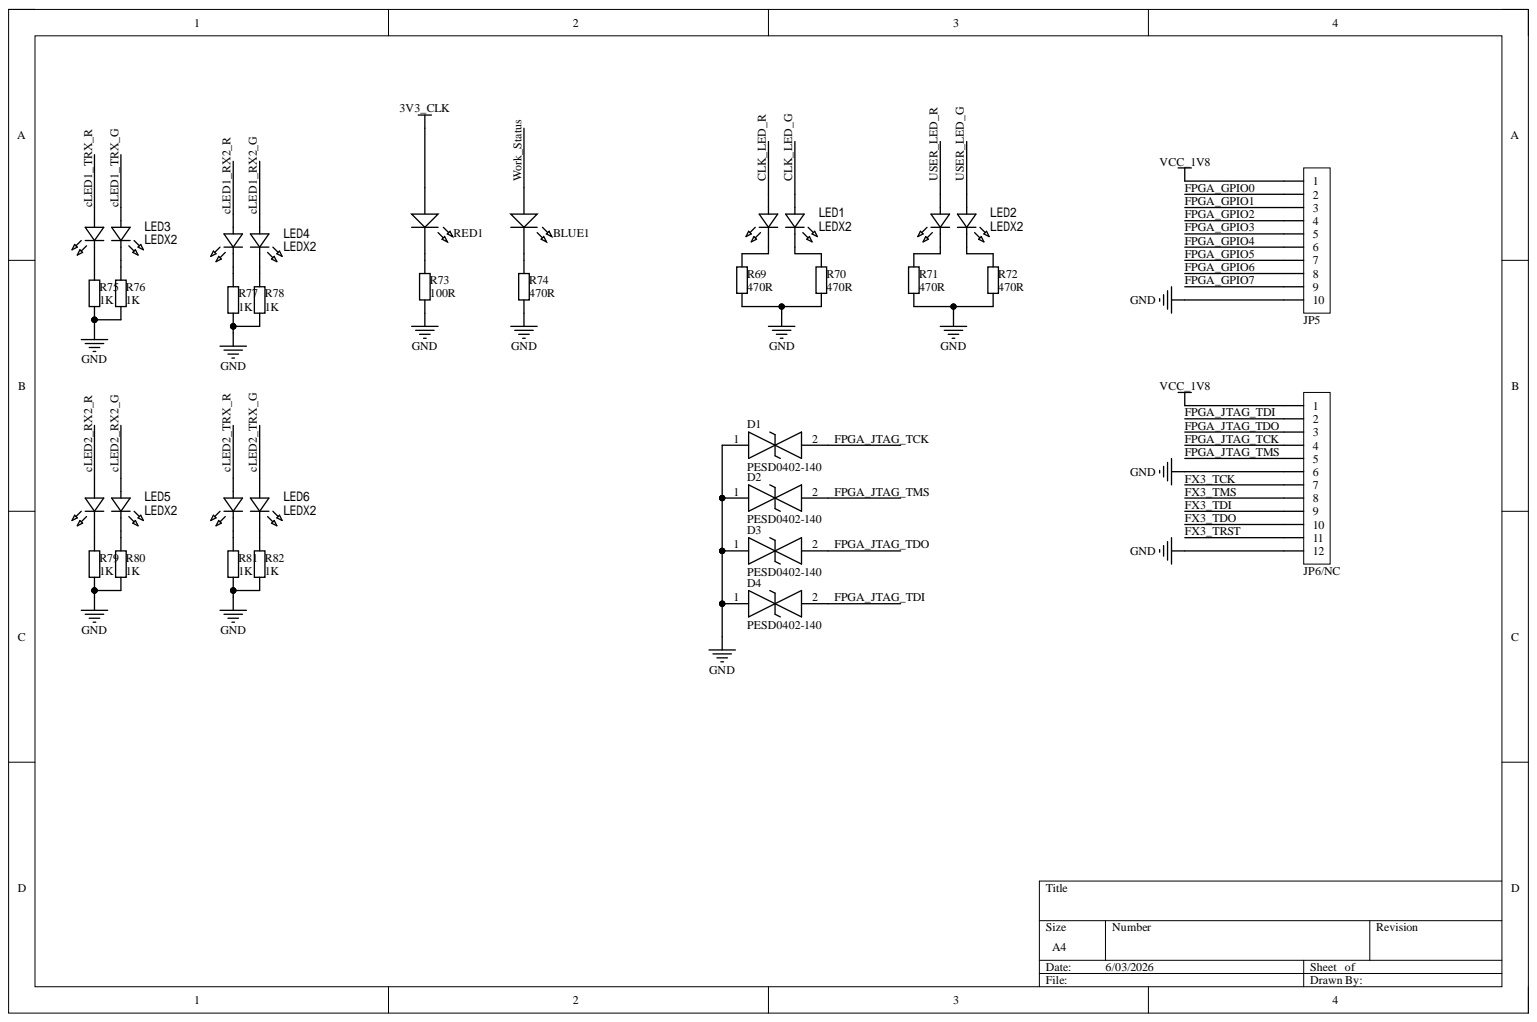
[picture p17: page 12]

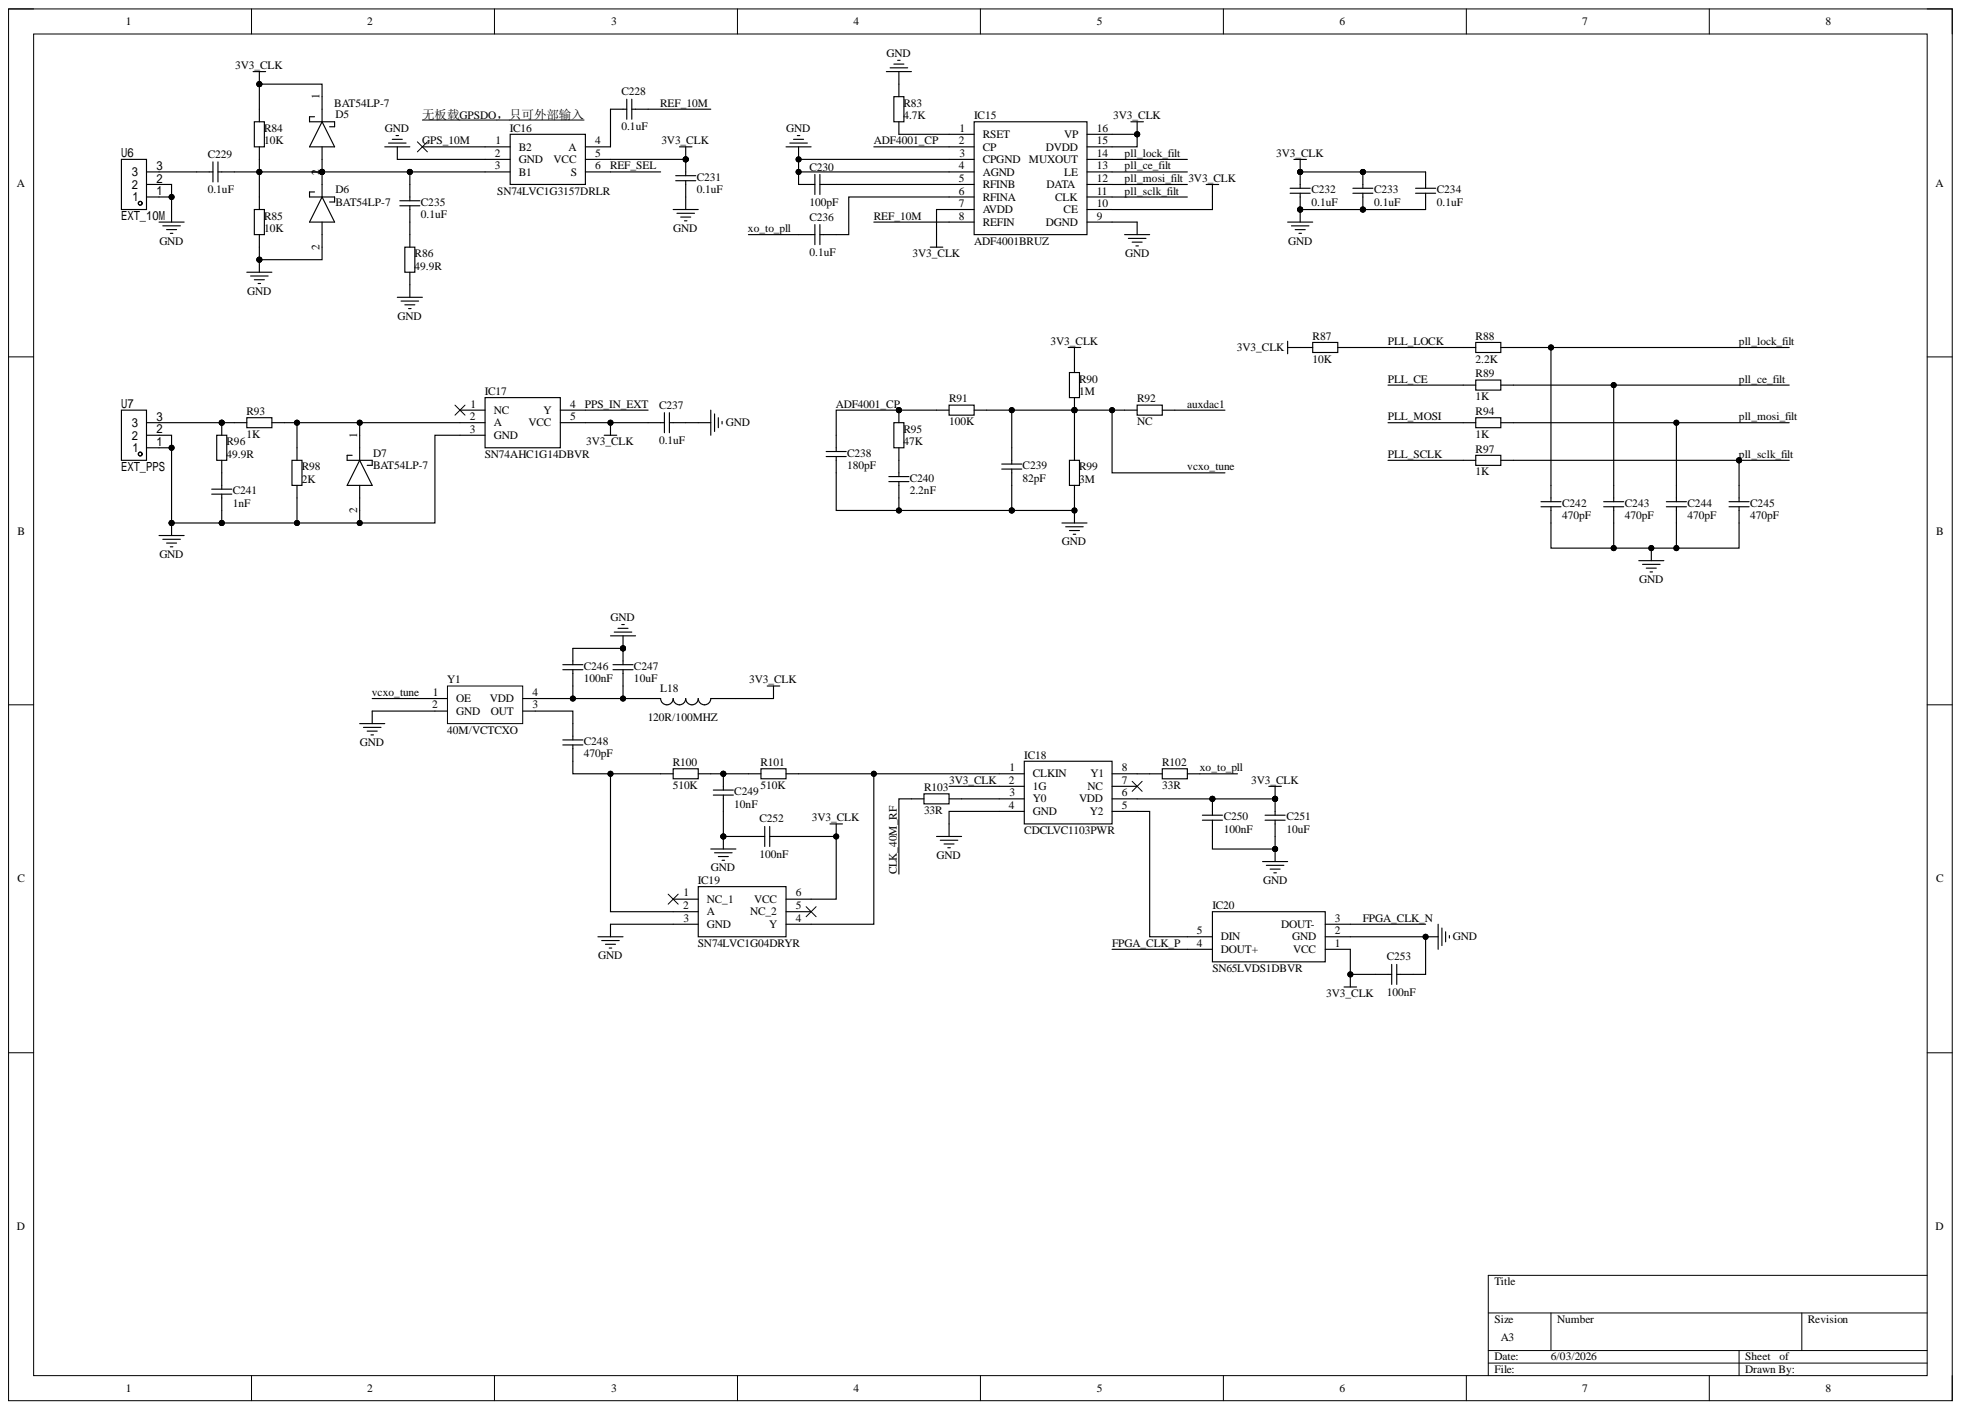
[picture p18: page 13]
