OpenSourceSDRLab/USRP-B210-Artix-7-AD9361/hardware/A7_B210.pdf

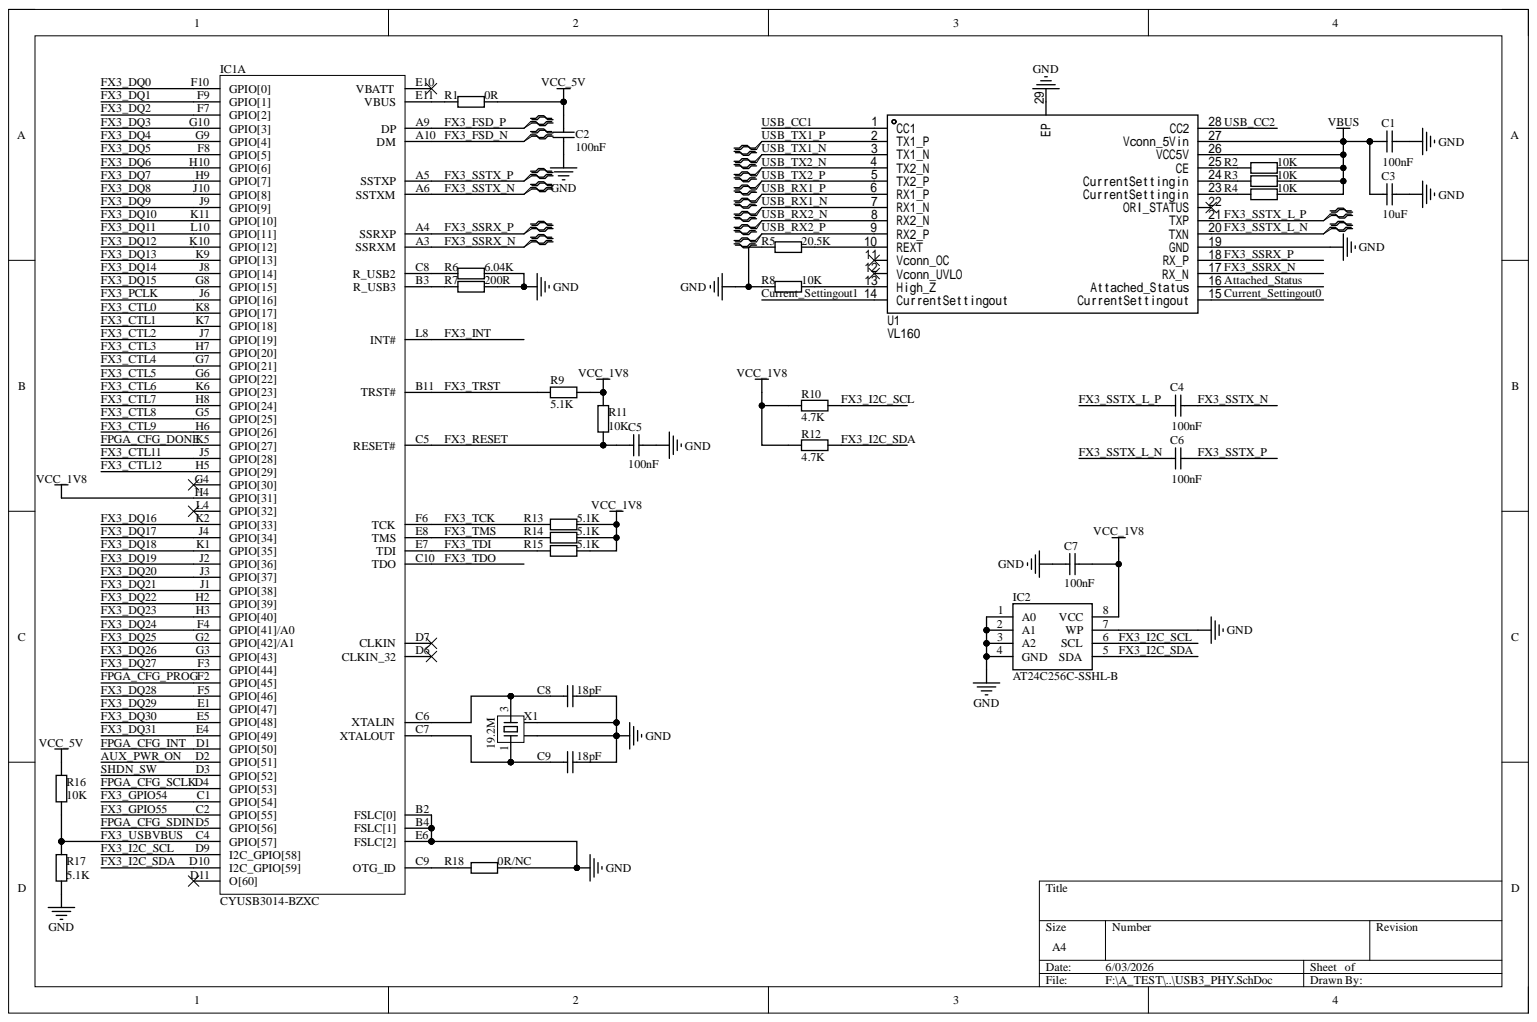
[picture p19: page 1]

E 8 FX 3 _ T M S R1 4 | 5 . 1 | K
E 7 FX 3 _ T D I R1 5 | 5 . 1

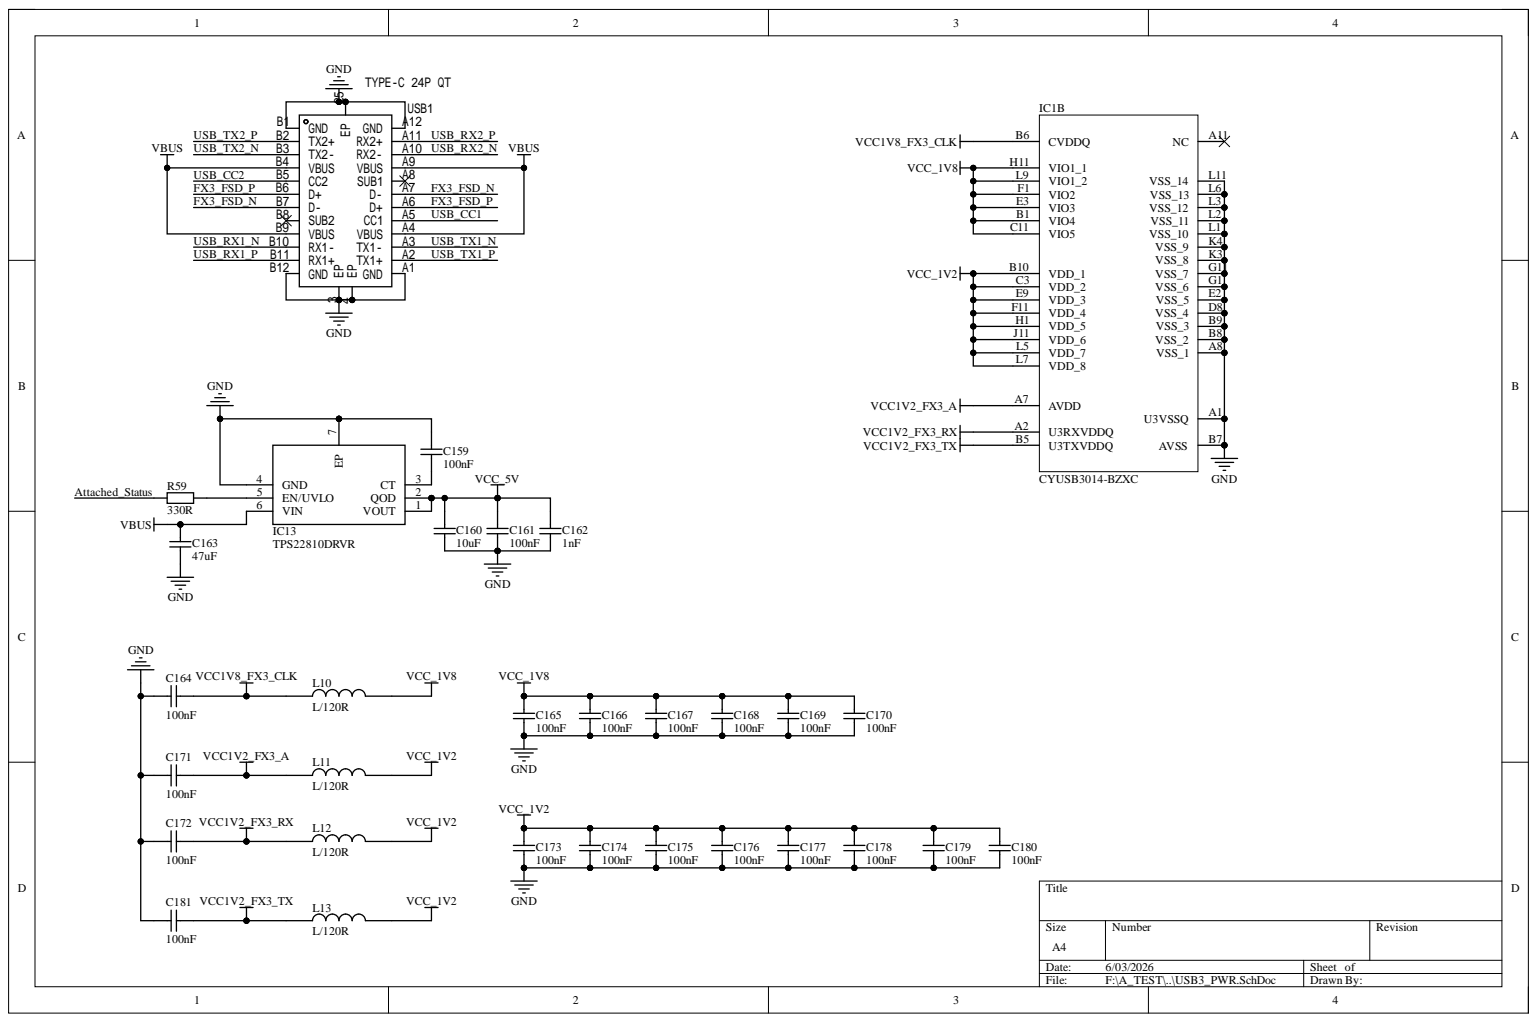
[picture p20: page 2]

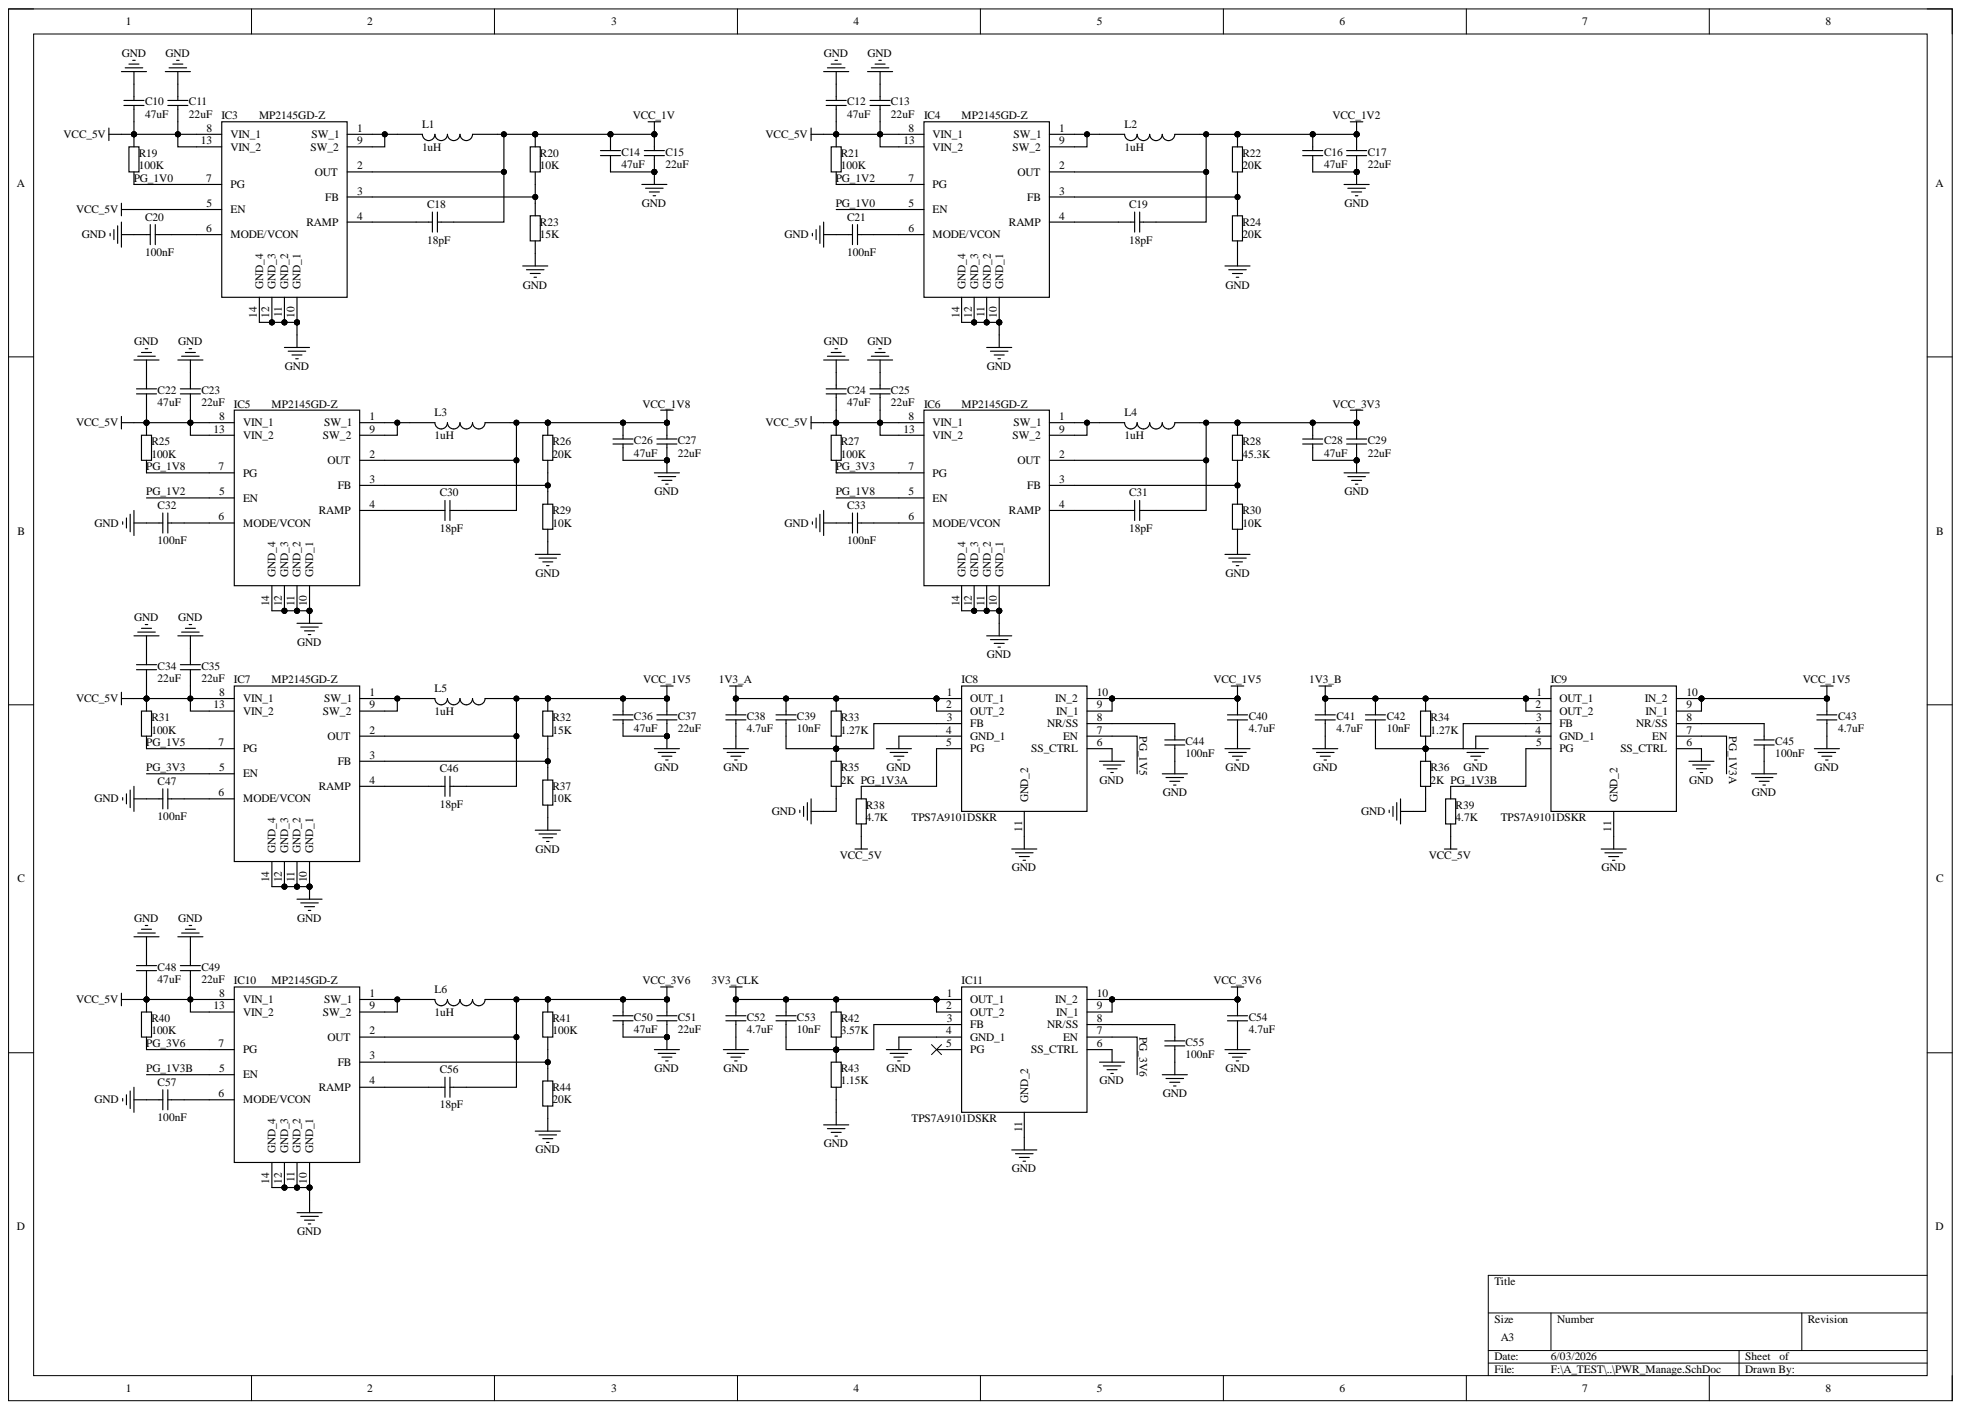
[picture p21: page 3]

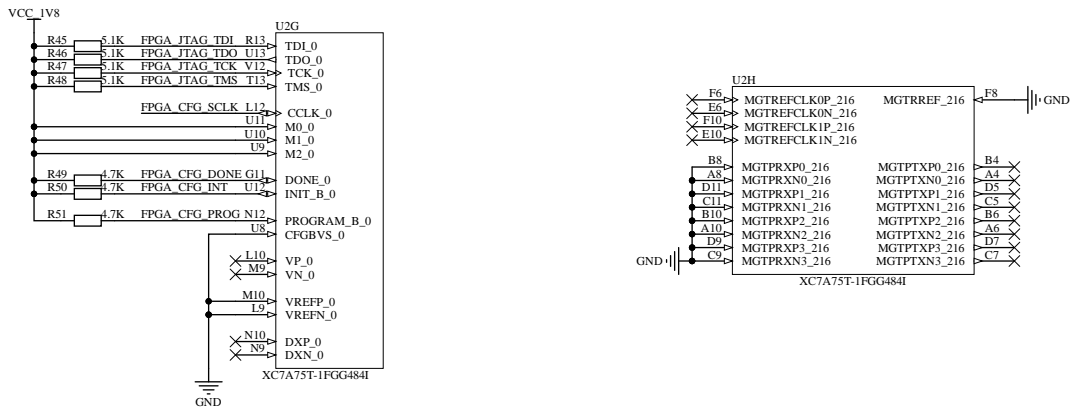
[picture p22: page 4]

R4 6 | 5 . 1 K FPG A _ J TA G_T D O
R4 7 | 5 . 1 K FPG A _ J TA G_ T C K
R4 8 | 5 . 1 K FPG A _ J TA G_ T M S T 1 3

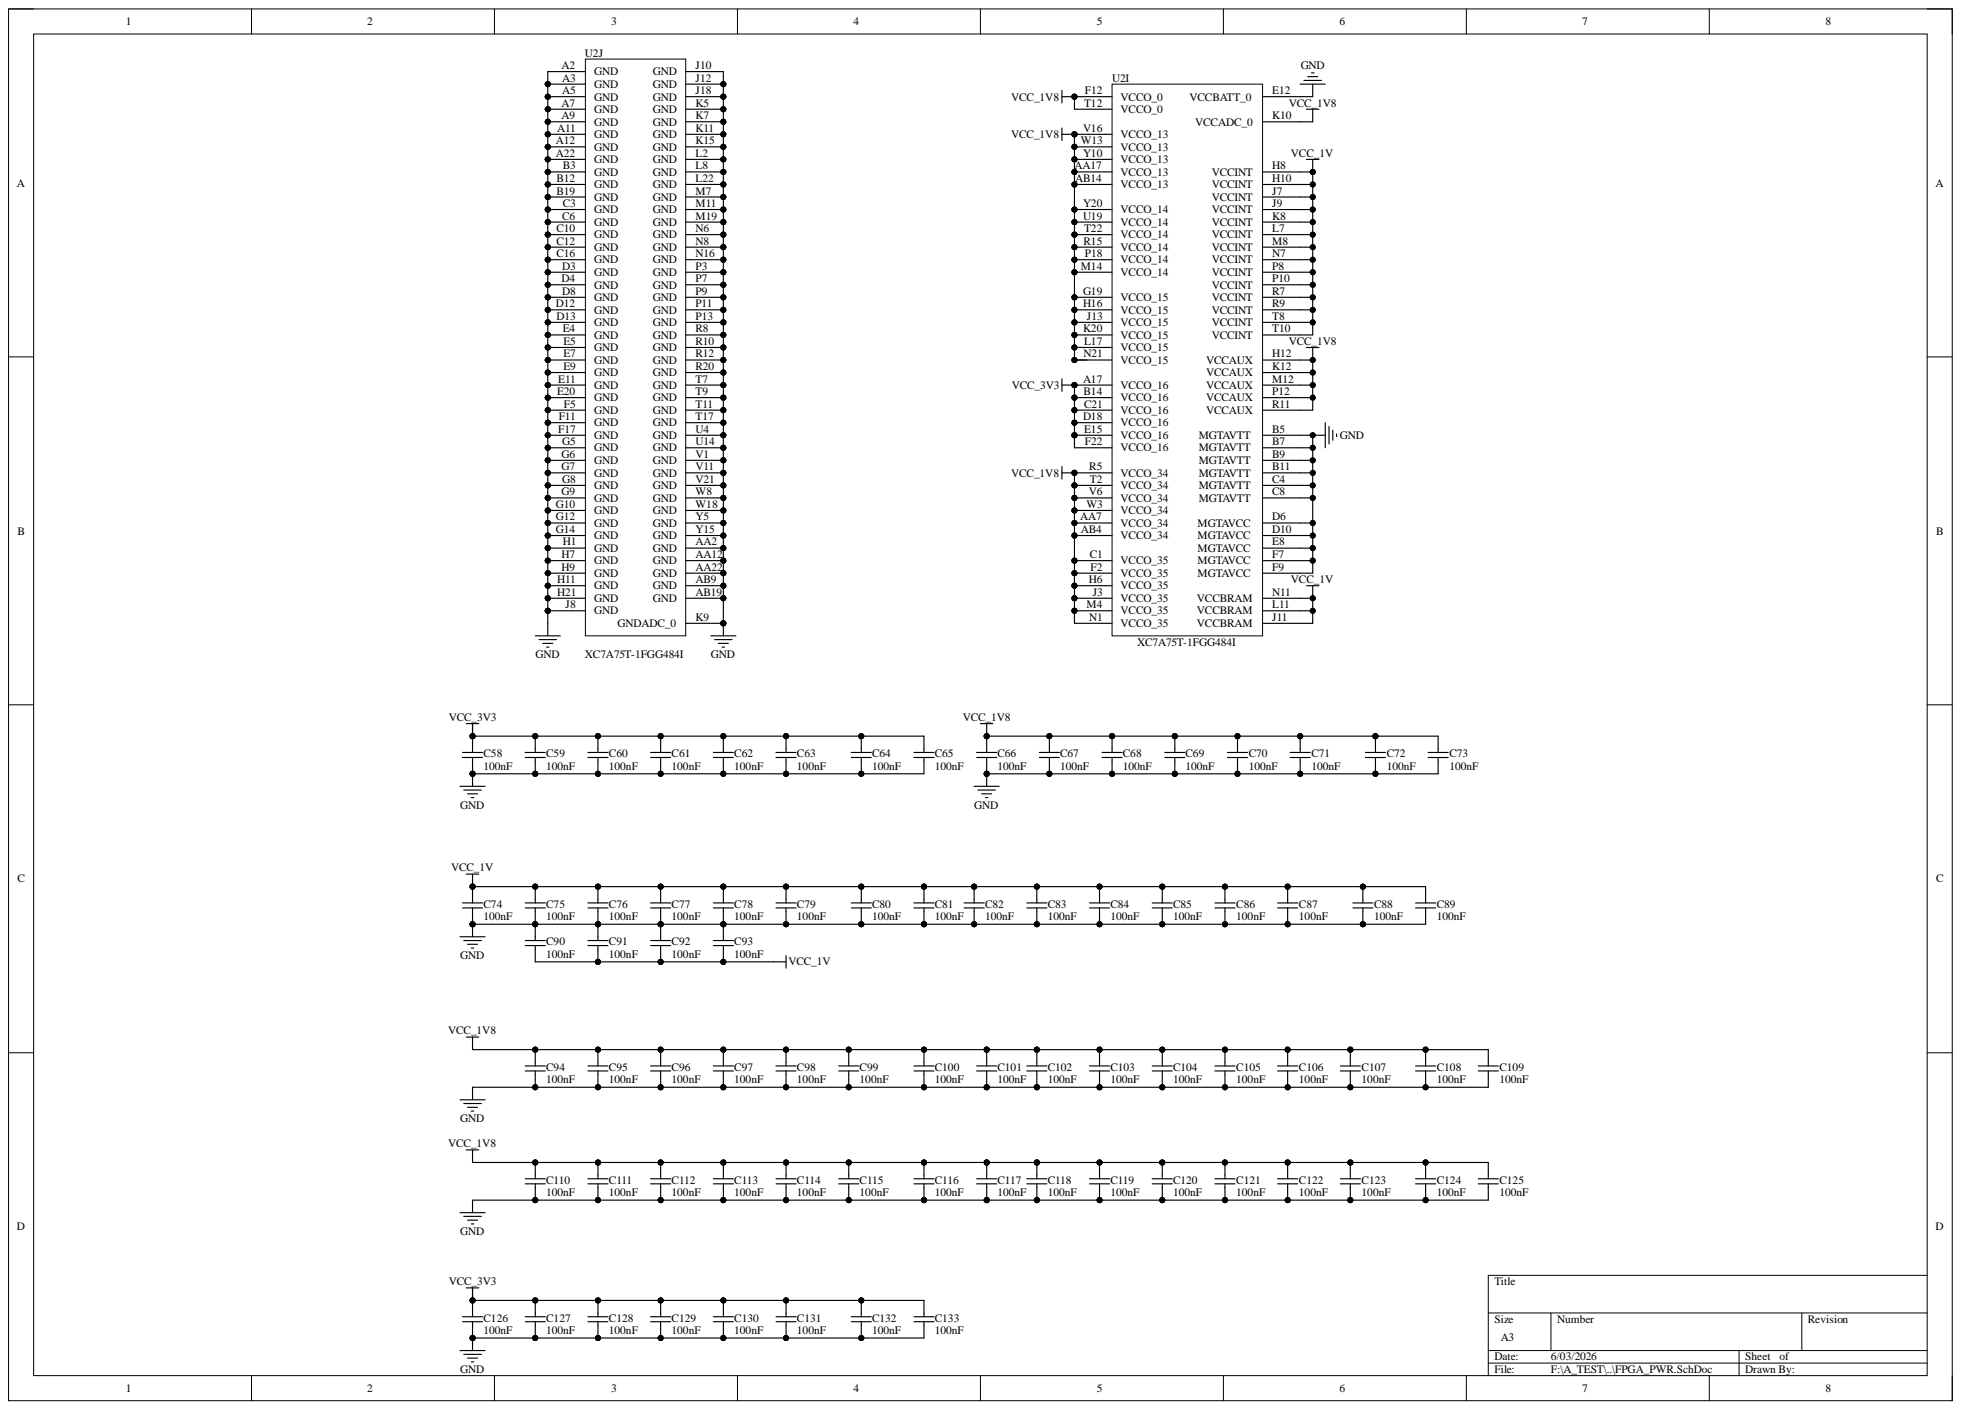
[picture p23: page 5]

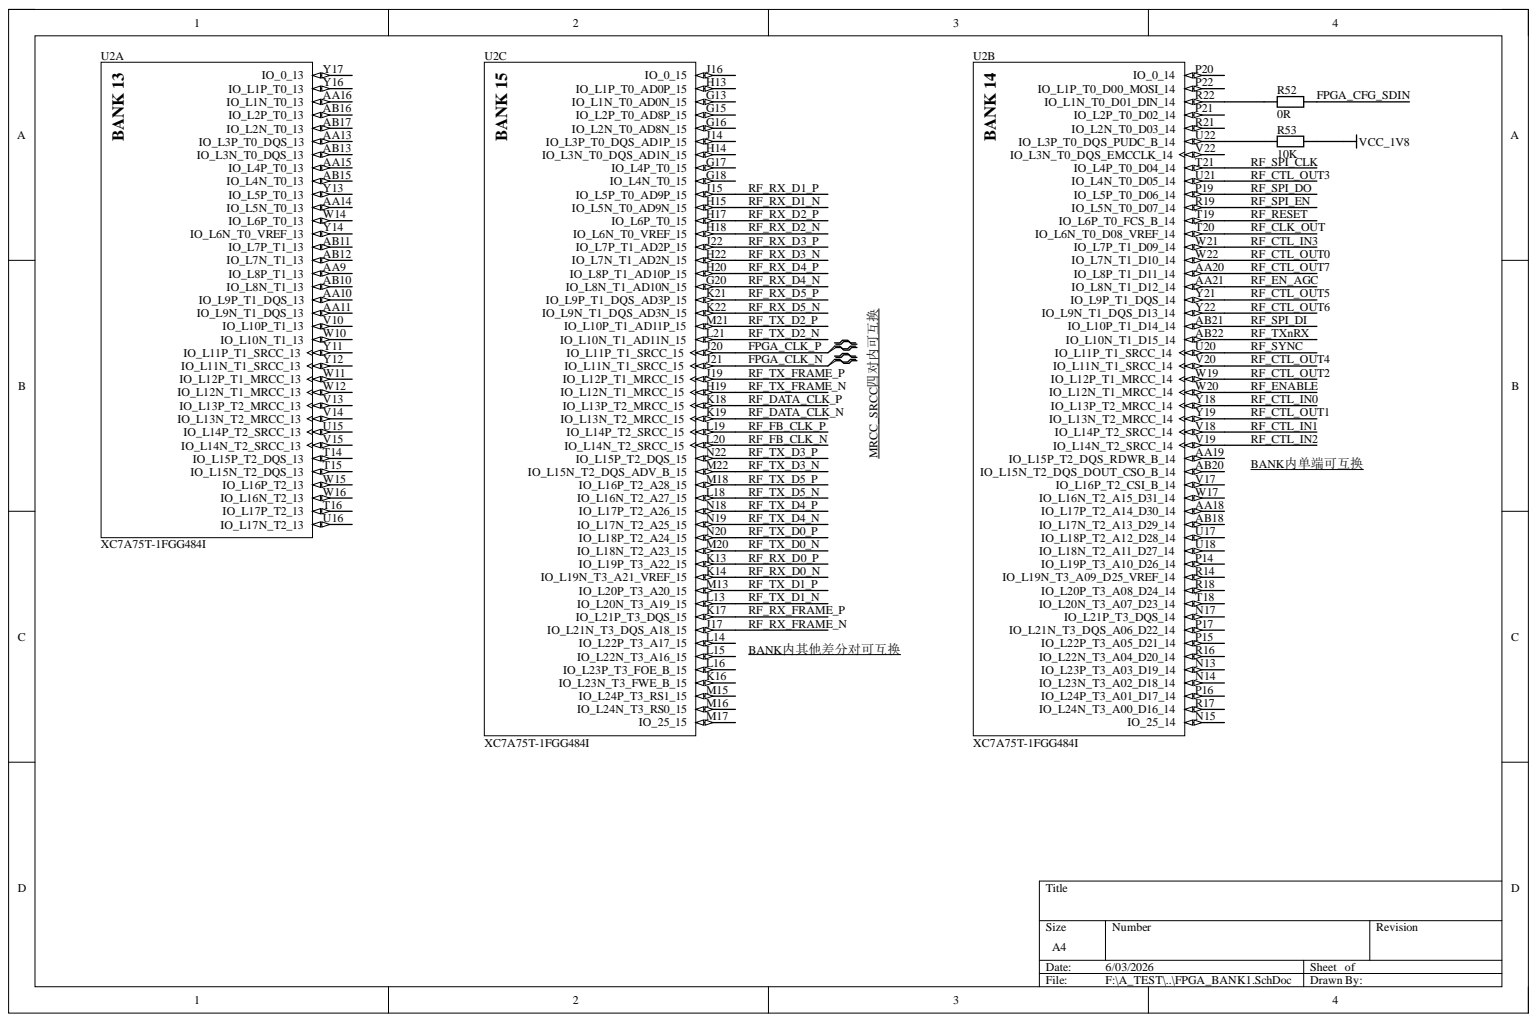
[picture p24: page 6]

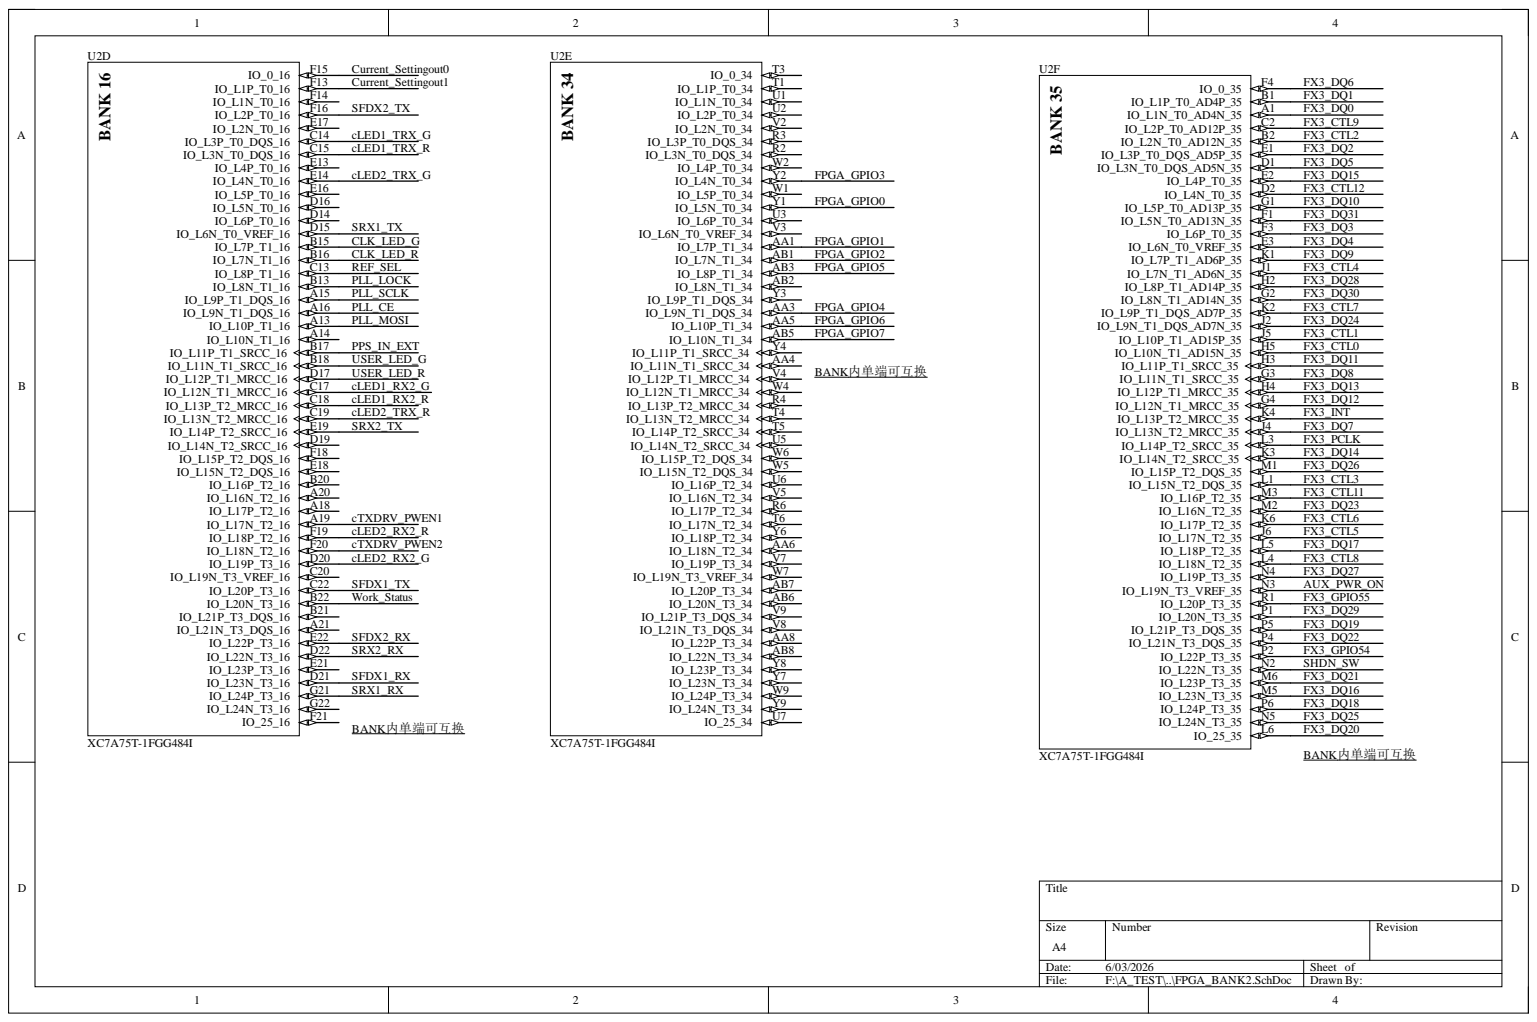
[picture p25: page 7]

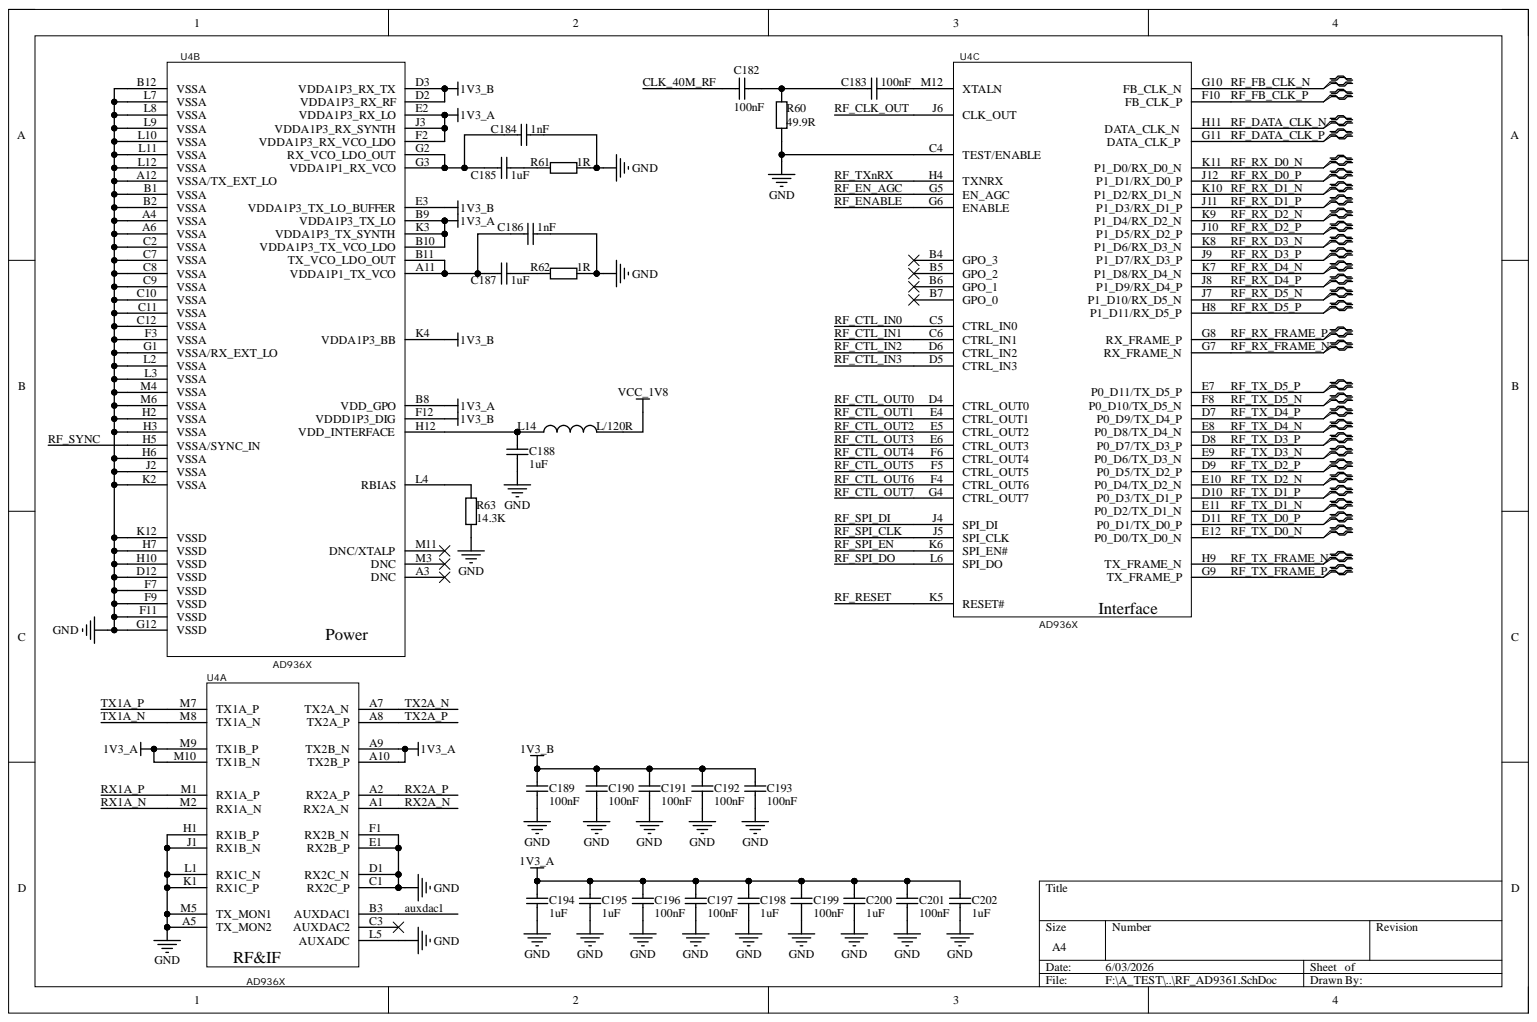
[picture p26: page 8]

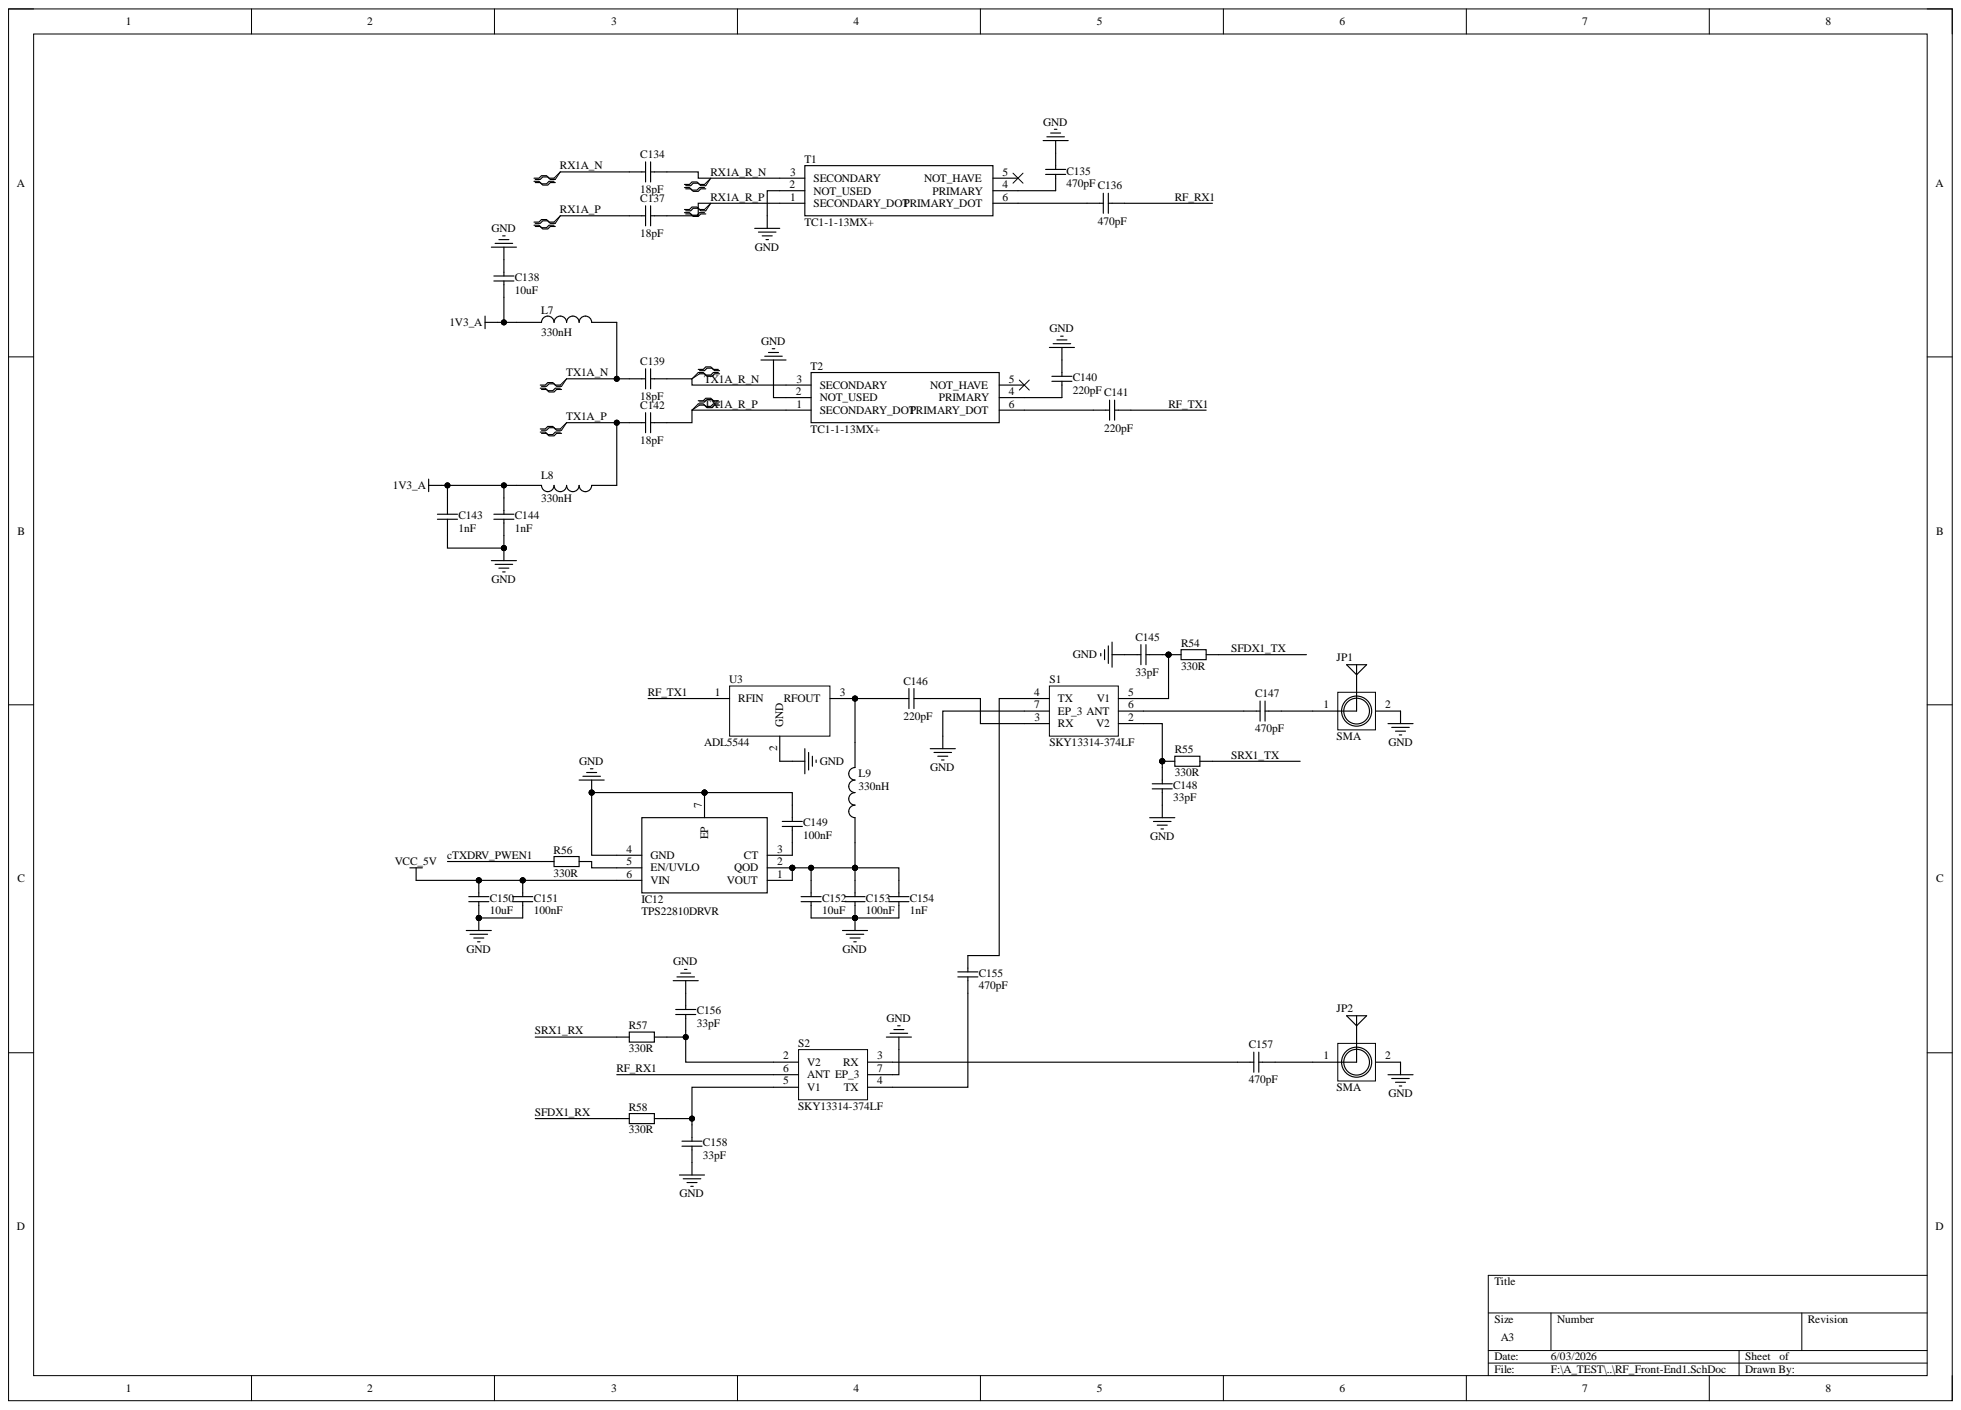
[picture p27: page 9]

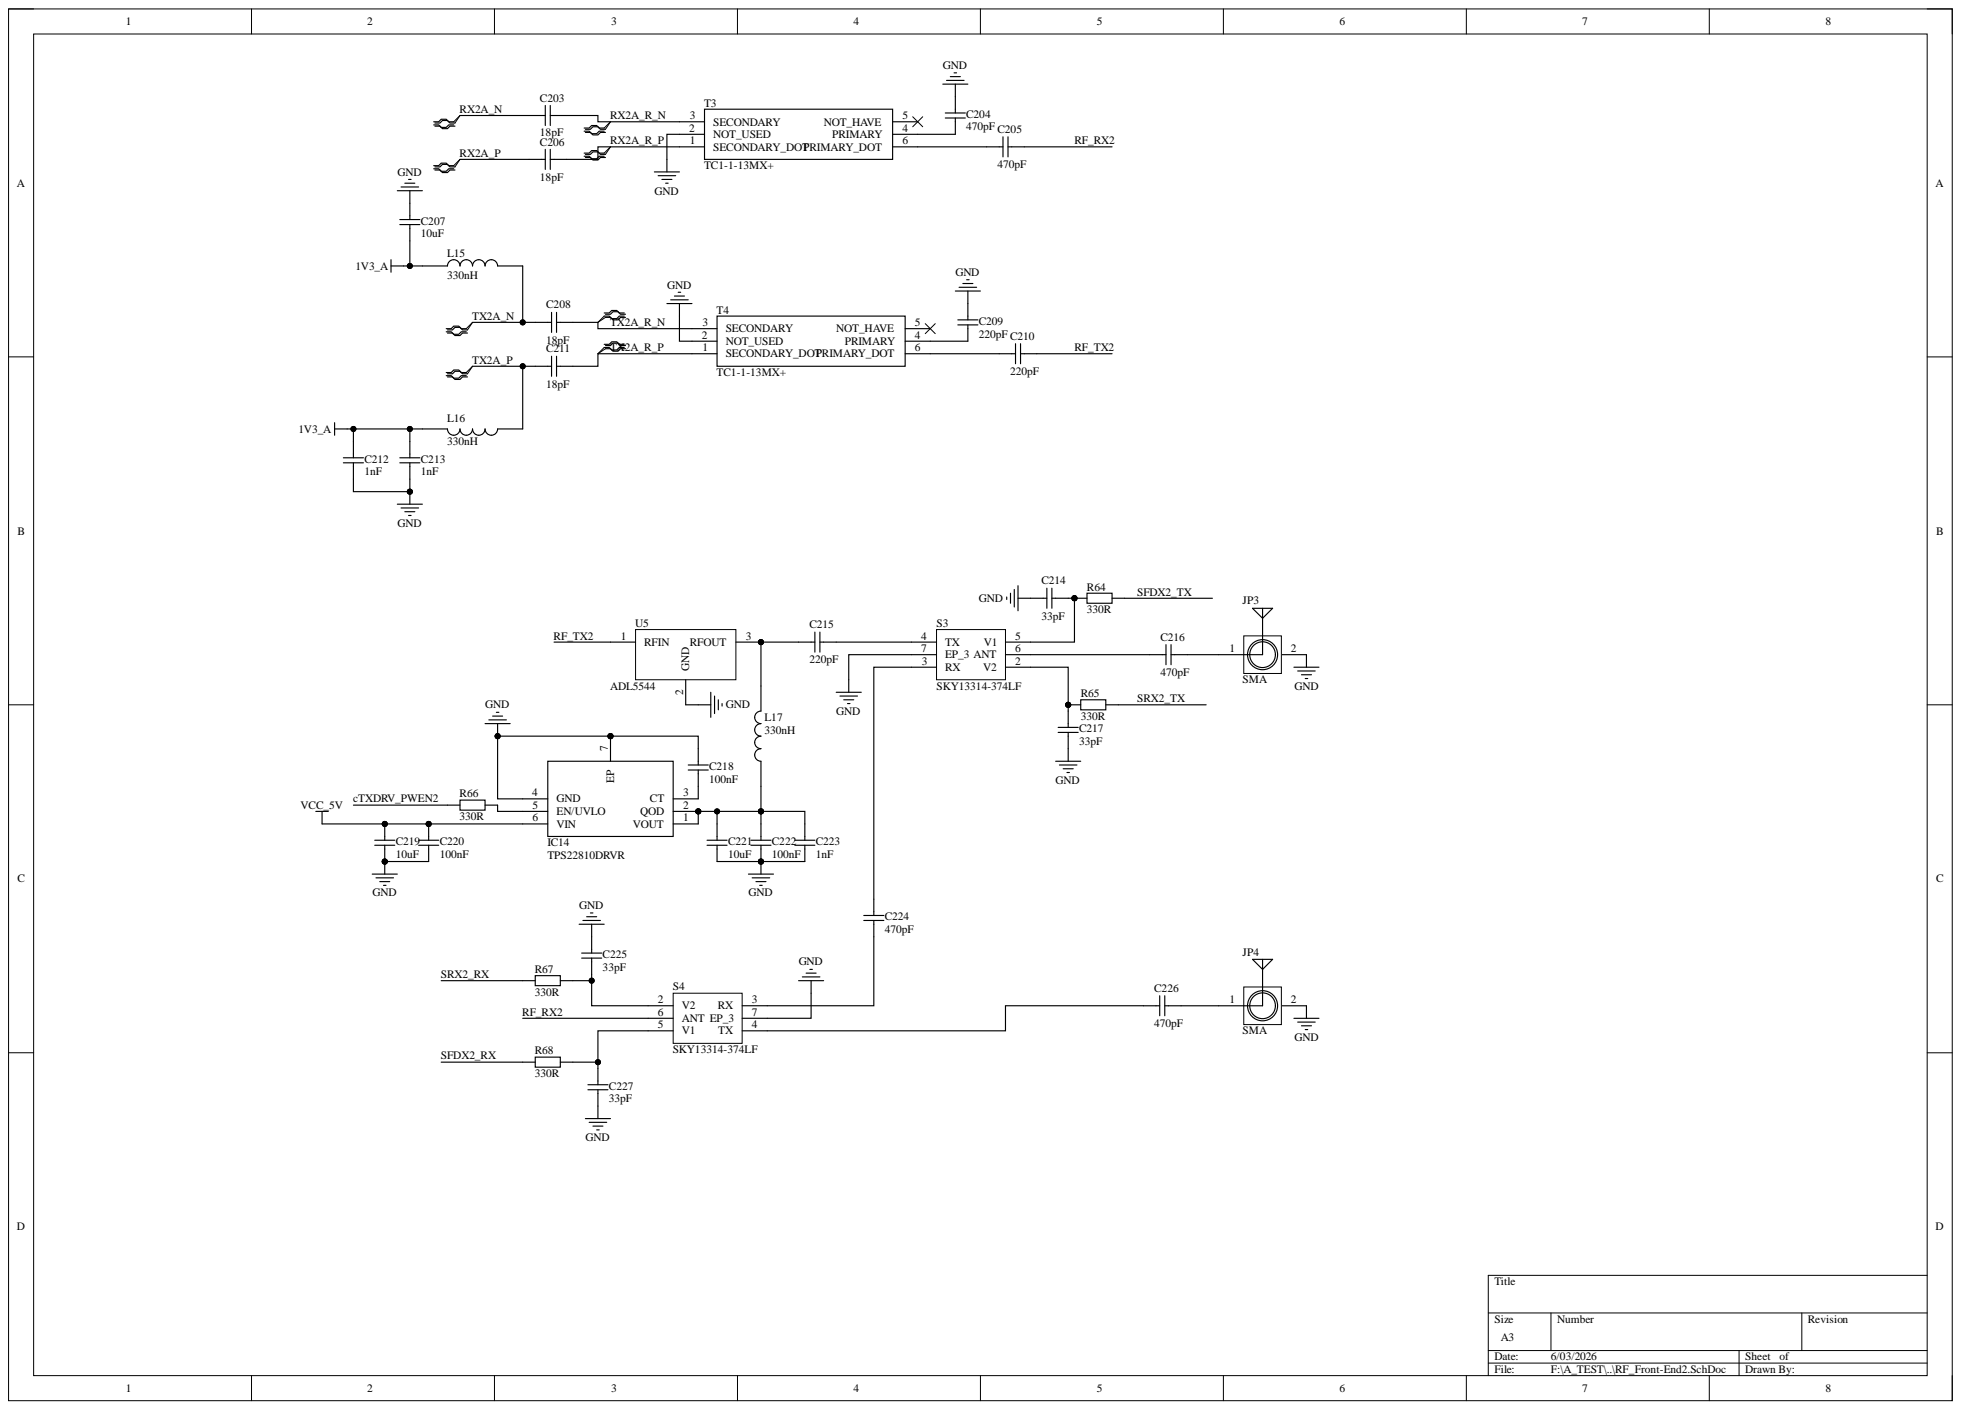
[picture p28: page 10]

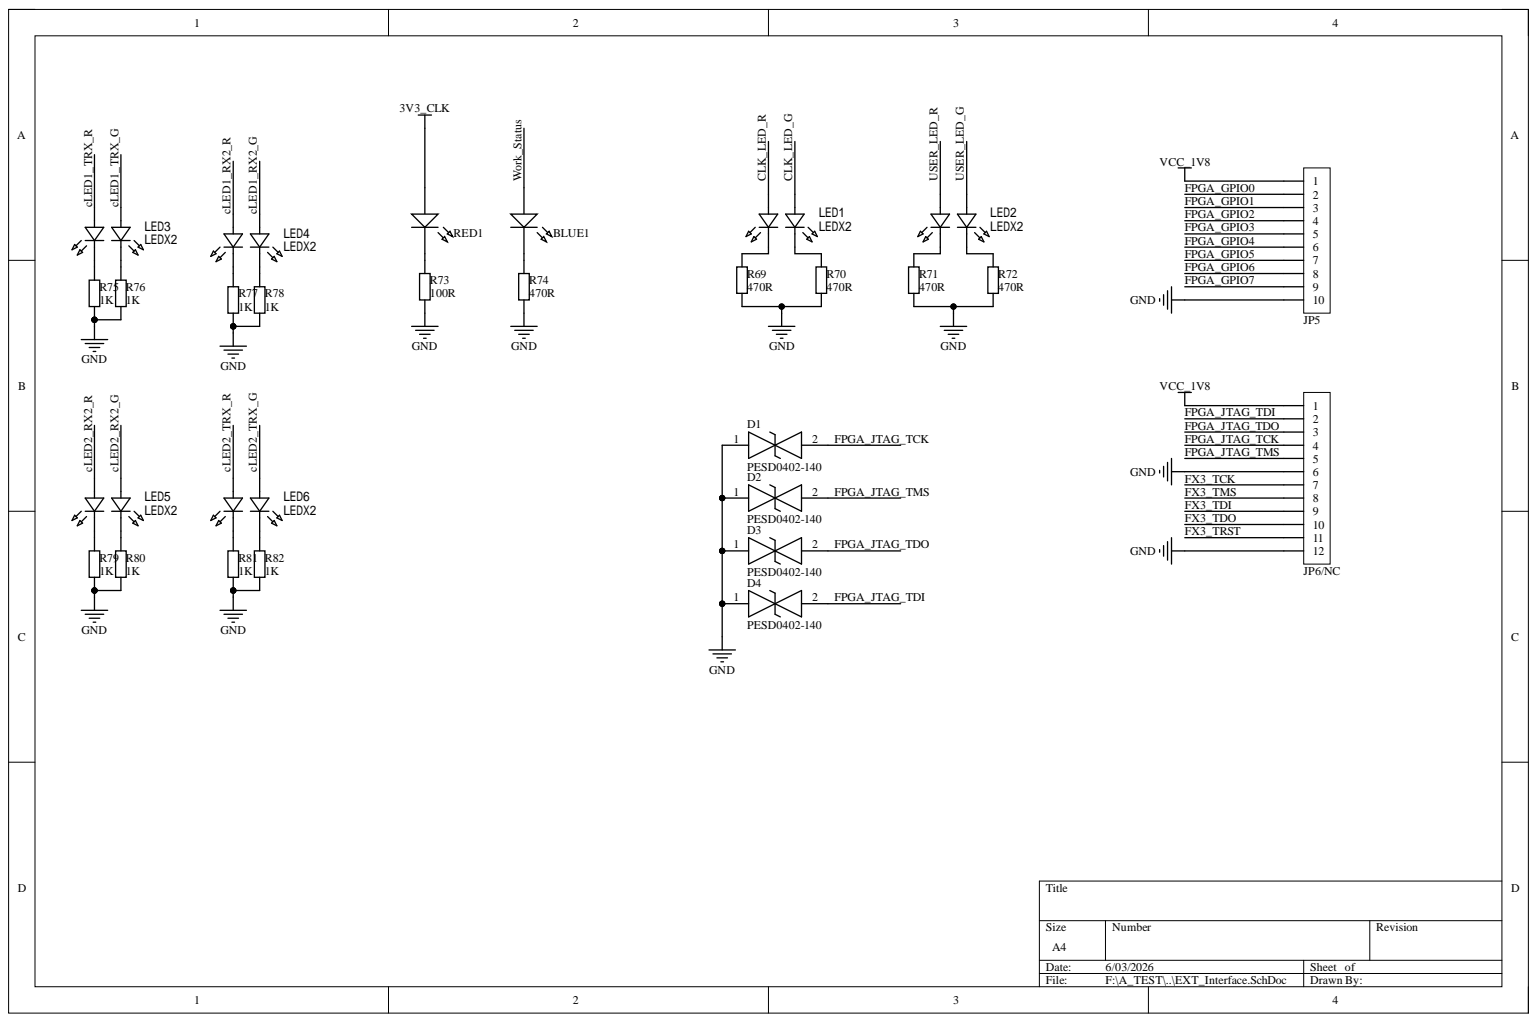
[picture p29: page 11]

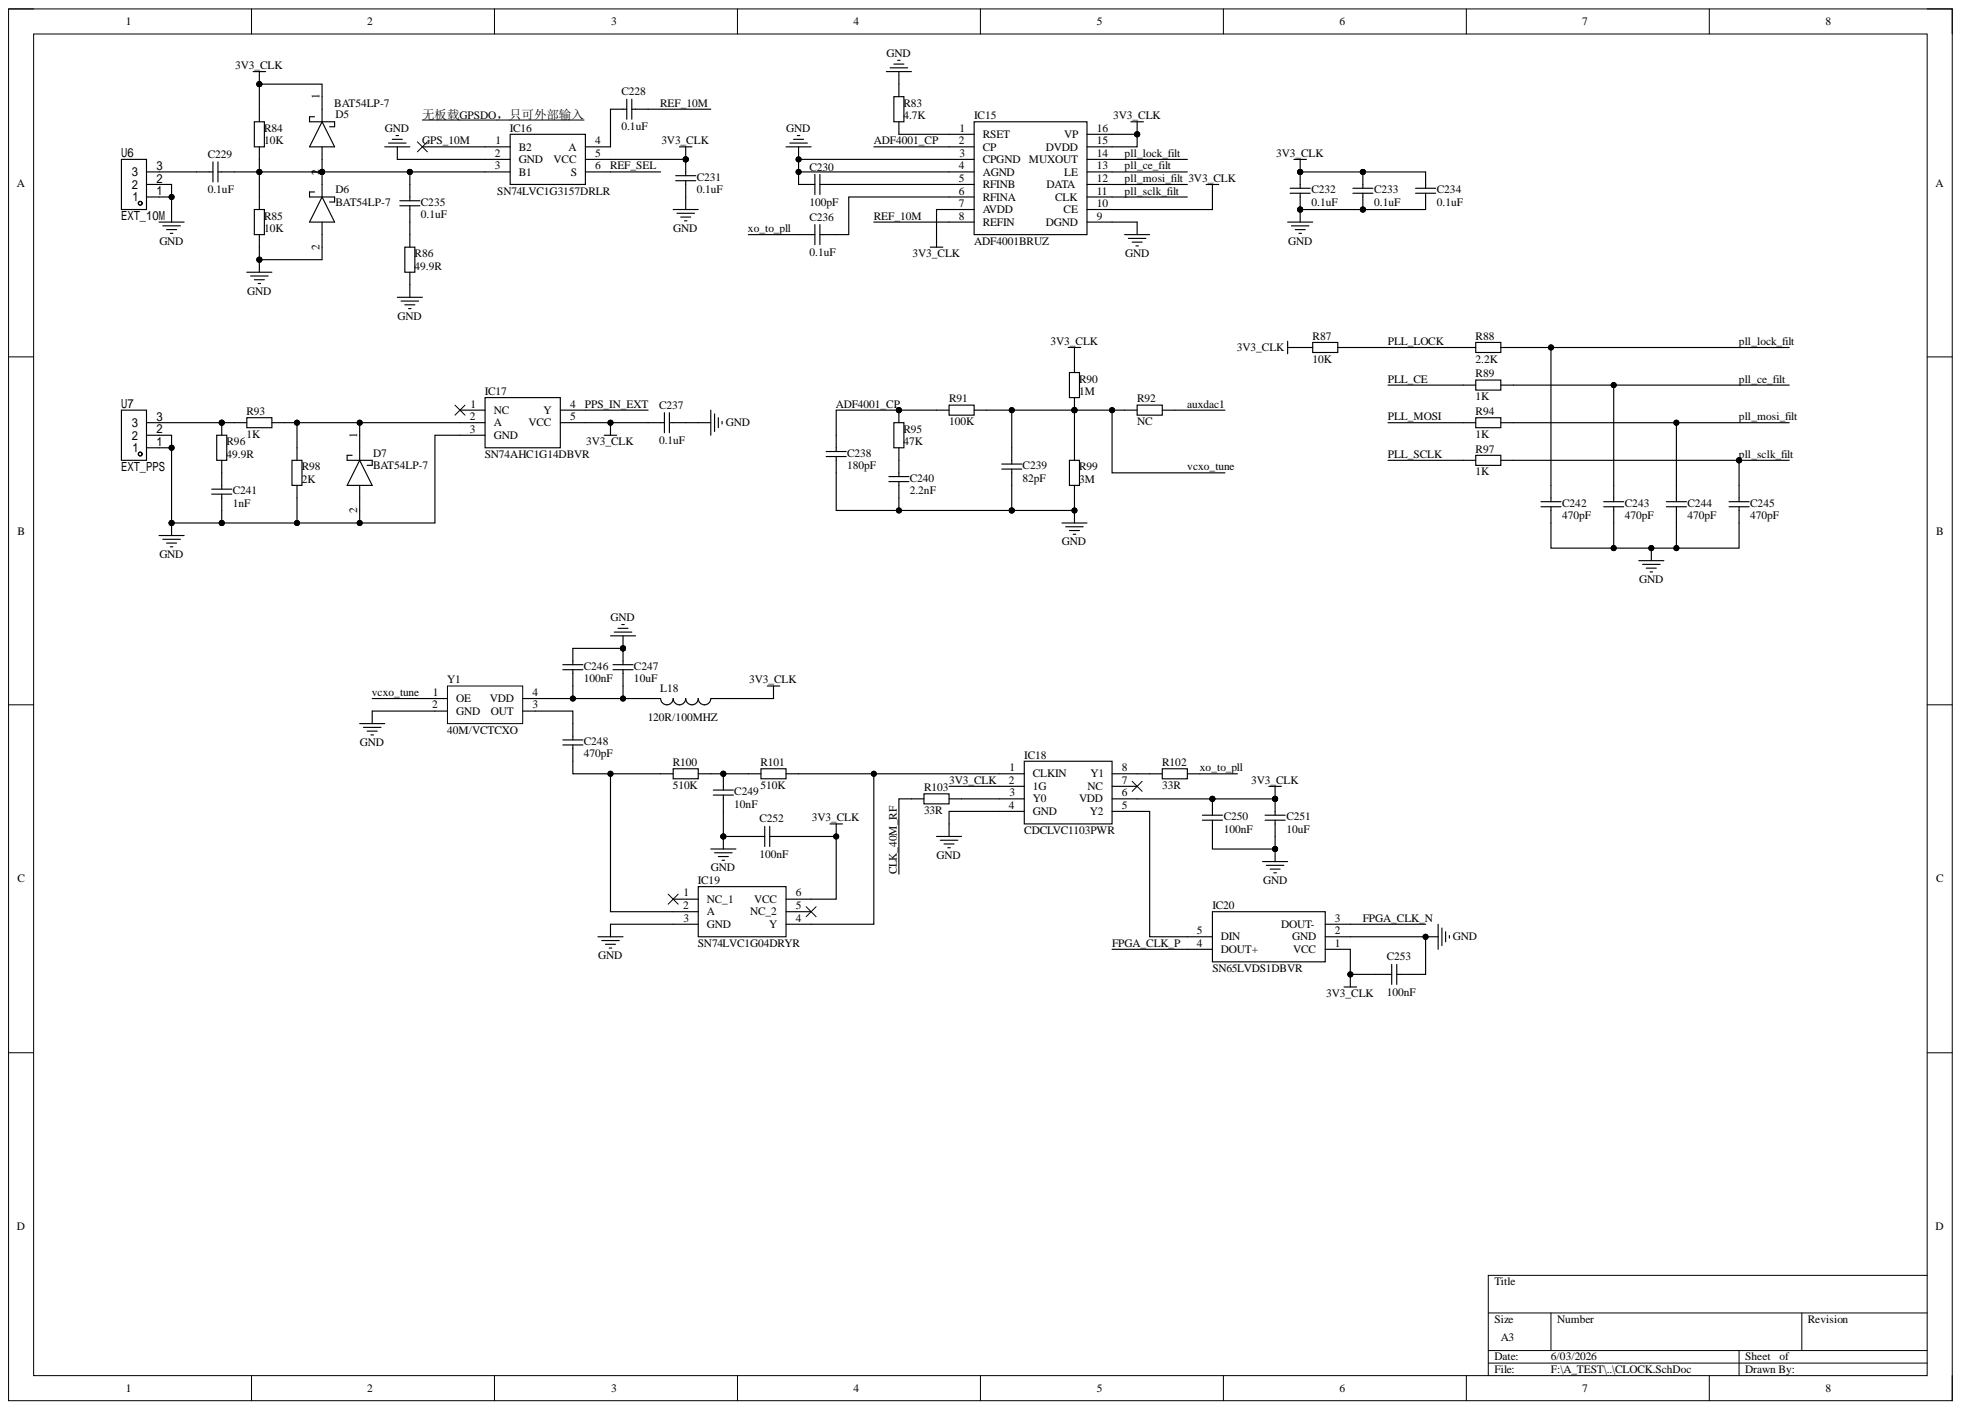
[picture p30: page 12]

RFINB 5 | pll_mosi_filt
RFINA 6 | pll_sclk_filt
AVDD 7
REFIN 8

C249 | 3V3_CLK R103 | | 1G 2
